IvanInAporia/temp_sensor/design/firmware_design.md

# temp_sensor firmware — design

What the device does, how the code is arranged, and which decisions are load-bearing.

| | |
|---|---|
| Target | STM32L010F4P6, **16 KB flash / 2 KB RAM**, Cortex-M0+ |
| Board | temp_sensor v2 (EasyEDA Pro) — see [`../easyeda/review-notes.md`](../easyeda/review-notes.md) |
| Sensor | TI HDC3020 on I2C1, permanently powered |
| Radio | Tuya T3-3S Wi-Fi module on LPUART1, **power-gated** |
| Supply | One NiMH AA cell → TPS61021A boost → 3.3 V |

---

## 1. What it does

Every five minutes: read the cell, read the sensor, decide whether the reading is
worth telling anyone (§4), and if so bring up the Wi-Fi module,
report temperature, humidity and three battery datapoints (percentage, level, and
whether the cell looks damaged), plus one with the lowest the cell was pulled to
in the windows before (§5), and put it away again. Then sleep.

A press of the Wi-Fi button opens the same window for pairing instead, and can
interrupt the sleep to do it. A press made while a report window is open opens one
as soon as that window closes. A device that isn't paired checks back with one short
window every 2 h until the button pairs it (§4).

When something went wrong since the last report got through (a reset, failed
windows or failed sensor reads), or the button opened a pairing window, the next
report also carries a line of diagnostic text, DP 104 (§4). A watchdog resets a board that stops making progress
(§5).

**Reports go out when the temperature moves, and at least every 4 h.** A move of
1.0 °C goes out at once, one of 0.3 °C once 30 min have passed since the last
report, and a room that holds steady still reports every 4 h, so the app can tell
it from a dead device and the battery state gets out (§4). Two other things in the
code follow from reporting on change: the first reading after boot always reports,
and a report is only "spent" once the module confirms the cloud has it.

## 2. Layout

```
libs/src/bsp/bsp.h          the portability boundary — one implementation per board
libs/src/sensor/            HDC3020 driver (trigger-on-demand, CRC-checked)
libs/src/battery/           NiMH cell voltage and sag -> percent, level, damaged
libs/src/report/            the spike filter, the "is this worth the radio" rule,
                              and the diagnostic record (DP 104)
libs/src/tuya_link/         the glue between the cycle and the vendor MCU SDK
temp_sensor_main/           the cycle itself
tuya/                       the vendor Tuya MCU SDK, ported (§7)

temp_sensor_STM32L010F4/    CubeMX project: HAL, startup, and
  Core/Src/bsp_stm32.c        >>> the only file that knows what the hardware is
libs/test/                  host GoogleTest suite (179 tests) over the same C
```

Everything above `bsp.h` compiles for both the target and the host, unchanged and
uncopied: the CubeMX project links `libs/src/*` and `temp_sensor_main/` in as
linked folders, and `libs/CMakeLists.txt` compiles the same files for the tests.
Only the two edges differ — the board (`bsp_stm32.c` vs `test/mocks/bsp_mock.c`)
and the vendor SDK (real vs `test/mocks/tuya_sdk_mock.c`).

**Porting to another board is writing one new file against `bsp.h`.** Nothing
above that header may include `main.h`, a HAL header or a CMSIS header, and no
pin number, peripheral handle or register name belongs on that side of it.

### The LPUART1 interrupt lives in `bsp_stm32.c`, on purpose

The Tuya SDK needs a byte-level receive interrupt armed for the whole time the
module is powered, and the `.ioc` does not enable the LPUART1 global interrupt —
so CubeMX generates neither the vector nor the NVIC call.

The obvious fix is to add it to the `.ioc` and hand-patch `stm32l0xx_it.c` and
`stm32l0xx_hal_msp.c` to match. **That was tried during this work and it silently
destroyed the receive path.** The project was regenerated, everything outside a
USER CODE block went with it, and the build still succeeded afterwards because
nothing references what went missing. The same regeneration also reverted LPUART1
and I2C1 from HSI16 to PCLK1, the I2C timing, the RTC prescaler and PA7's EXTI —
none of which any test or build could see.

So both halves live in [`bsp_stm32.c`](../temp_sensor_STM32L010F4/Core/Src/bsp_stm32.c),
which CubeMX never touches: `LPUART1_IRQHandler` overrides the weak vector in the
startup file, and the NVIC line is enabled once in `BSP_Init()`. If a future
`.ioc` revision ever does enable that interrupt, both definitions will exist and
the link will fail with a duplicate symbol — the loud version of the same problem,
and the right one to have.

The ADC interrupt behind the sag monitor (§5) lives there for the same reason:
`ADC1_IRQHandler` is defined in `bsp_stm32.c`, and its NVIC line is enabled by the
monitor's start and disabled by its halt, never left on.

**Do not "tidy" this into the generated files.**

## 3. The cycle is straight-line code

There is no scheduler, no task, no coroutine and no state machine.
[`temp_sensor_main.c`](../temp_sensor_main/temp_sensor_main.c) is a list of steps
in the order they happen, and a wait is a call that returns when the wait is over:

```c
bool pairing = PairingRequested();

uint16_t battery_mv = BSP_Battery_ReadMv();     /* before any load is switched on */

if (Hdc3020_Read(&reading))
{
    report_due = ReportPolicy_Update(&report_policy, reading.temp_c10, next_cycle_ms, &temp_c10);
    Tuya_SetDps(temp_c10, reading.rh_pct, battery_pct, battery_state);
}

if (report_due || pairing)
{
    RunWifiWindow(report_due, pairing, temp_c10);
}

WaitForNextCycle();
```

This is affordable because **nothing on this device is concurrent.** One job per
wake; the sensor read is a blocking 15 ms; during a Wi-Fi window the module is the
only thing drawing current and there is nothing else that needs the CPU. The only
concurrency is the LPUART receive interrupt, which pushes one byte into the Tuya
SDK's ring buffer and re-arms itself.

What makes the blocking waits cheap is `Tuya_WaitUntil()`: it blocks, but it
services the SDK and idles the core on every pass, so "wait 25 seconds for the
cloud" costs interrupt wakeups rather than a spin.

**The rule that keeps this honest: every wait has a deadline.** Nothing may wait
on the module forever. It is a separate processor on the far end of a UART with no
reset line; if it never answers, the cycle ends and a later one tries again (§4).

**The watchdog is the backstop for that rule** (§5). `Tuya_WaitUntil` feeds it on
every pass, which is only safe because every wait it runs has a deadline. A three-
minute pairing window is far longer than the watchdog's timeout, and that time is
spent in this loop. Anything that waits *without* a deadline (a vendor HAL loop
polling a flag against a stopped tick, the CubeMX `Error_Handler`) stops feeding
it and gets the board reset.

**No state stops the device for good.** On 2026-11-11 the kitchen board went
quiet for about 9 h after a house-wide outage and came back the moment its Reset
button was pressed. The cloud log couldn't say why, but the firmware then had
three ways to end up there: the unpaired latch, a sensor bus left busy, and a hang
with no watchdog. All three are gone. Unpaired is now re-checked every 2 h, a
failed read resets the bus, and the watchdog catches hangs. The report after a
reset now says what came before it (DP 104).

## 4. Why measuring and reporting are priced differently

One HDC3020 conversion is ~110 µA for 13 ms. One report is the T3-3S cold-booting,
associating and reaching the cloud — seconds at tens of milliamps, and on a single
NiMH cell feeding a 3.3 V boost, roughly three times that current *at the cell*.

That ratio is most of the battery life, so the cycle measures often and reports
rarely. The rules, in [`report_policy.h`](../libs/src/report/report_policy.h):

- **A spike must not buy a report.** A median of the last three samples is the
  whole filter — it rejects any single outlier outright, whatever its size. The
  cost is one sample of lag on a genuine step, which at a five-minute cadence
  means a real change is reported up to two periods after it starts.
- **Only temperature triggers.** Humidity is far noisier and would undo the first
  rule; the battery moves so slowly that any useful threshold would take days to
  cross. Both ride along on whatever report the temperature triggers, and the 4 h
  report carries them out of a steady room.
- **`REPORT_TEMP_DELTA_C10` is 0.3 °C**, a little over the sensor's own ±0.2 °C
  typical accuracy, so a report means the temperature moved rather than that the
  sensor wandered.

### How often a report goes out

Three rules, each against the last report that reached the cloud: how far the
filtered temperature has moved from it, and how long ago it was.

| Since the last report | Moved | |
|---|---|---|
| any time | 1.0 °C or more (`REPORT_TEMP_DELTA_FAST_C10`) | report |
| 30 min or more (`REPORT_HOLDOFF_MS`) | 0.3 °C or more | report |
| 4 h or more (`REPORT_MAX_SILENCE_MS`) | anything | report |

- **The hold-off caps small changes at 48 reports a day.** On the 0.3 °C rule
  alone a heating cycle swinging 0.6 °C every 20 min would send 144 a day; with
  it, 48. When the hold-off ends the current reading goes out, so the app is back
  within 0.3 °C. The cost is that a change under 1.0 °C can reach the app up to
  30 min late.
- **The 4 h report tells a steady room from a dead device.** The app shows the
  device offline between windows, so the cloud log is the only sign of life, and
  it shows repeated values. The 4 h report also gets the battery state out of a
  room that never changes. It costs at most 6 reports a day, and only in a room
  that sends almost nothing else.
- **It is an ordinary report.** It commits like any other, and the backoff and
  the unpaired flag apply to it unchanged. It needs a good sensor reading, so a
  dead sensor goes silent instead of repeating its last value: no new log entry
  for more than about 4 h means something is wrong. The code never calls it a
  "heartbeat", which is the Tuya protocol's cmd 0x00.
- **Times are on the schedule** (`next_cycle_ms`), like the backoff and for the
  same reason. The time since the last report stops growing at 4 h, so it can't
  wrap after 49.7 days.
- **What it saves depends on the room.** Replayed on the logs from 2026-10-31 to
  11-07 (`tools/tuya_logs`, with the signal between reports rebuilt by
  interpolation): front board 84 → ≈44 reports a day, kitchen 12 → 10, office
  16 → 15. Indoor rooms barely change. The front board's temperature moves all
  day, and the hold-off halves its reports.

### Deciding and committing are two calls

`ReportPolicy_Update()` decides; `ReportPolicy_ReportSent()` commits. A window that
did not deliver simply never commits, so the next cycle still finds the change
outstanding. Otherwise a dropped report would wait for the next 4 h report, far
too late for a change worth sending.

Any window that delivers commits this cycle's reading, pairing windows included:
it pushed that reading, so the 0.3 °C and the 4 h count from it. A cycle whose
sensor read failed commits nothing, because what went out was an older reading.

### Delivered means the module said so

Reaching the cloud is not the same as delivering. The kitchen board's window at
08:34 on 11-10 came online in the Tuya event log, but its DPs never showed up, and
the firmware committed them anyway. About 1 in 20–28 windows looked like that on
the kitchen and office boards.

So the push after the cloud is up (`Tuya_ReportCachedDpsWithAck`) sends DPs 101,
103 and 104, then humidity and the battery DPs as plain reports, and the
**temperature last, as a synchronous report** (cmd 0x22). The module answers it
(0x23) once the cloud has it, or refuses after 5 s if it can't deliver. The
plain reports go ahead of it on the same connection, so that one answer covers
the whole push. It is only one because the SDK allows no second synchronous
report before the first is answered (`tuya/protocol.h`, item 14). The answers to
the module's own status queries (`all_data_update`) stay plain.

| The module | The report | The window |
|---|---|---|
| answers yes | delivered, committed | powers off at once: no 2 s drain |
| refuses | not delivered: retried like a failed window | powers off at once |
| does not answer within 6 s, and has answered before in this run | not delivered | powers off |
| does not answer within 6 s, and never has in this run | delivered, by the old rule (reaching the cloud is delivering) | the run stops asking: later windows push plainly and drain 2 s |

- **Whether the module answers at all is unverified** for firmware 3.0.93
  (todo.md, hardware check 5). The last row is the fallback that keeps a module
  without 0x22 working as before, at the cost of one 6 s wait per boot.
- **A pairing window still drains 10 s**, whatever the answer: the app is still
  registering the device.
- **An answer saves power too.** A window powers off as soon as the answer is in,
  rather than holding the module up for the fixed 2 s.

### Backing off after failed windows

A failed window is the most expensive thing the device does: about 29 s with the
module powered (~4 s to alive, then the 25 s cloud timeout). With the router down
every window fails, and retrying the outstanding report on every cycle would keep
the module powered ~10 % of the time — a flat cell in three or four days. So
[`temp_sensor_main.c`](../temp_sensor_main/temp_sensor_main.c) retries twice and
then pauses:

| Failed report windows in a row | Next report window no earlier than |
|---|---|
| 1 or 2 | 5 min after the failed one (`REPORT_RETRY_MS`) |
| 3 | 2 h after it (`REPORT_PAUSE_MS`) |
| any one that found the module unpaired | 2 h after it, with no quick retry spent |

- **Only a window that delivers gives the retries back.** The try at the end of a
  pause gets none of its own, so a long outage costs one window every 2 h, about
  12 a day. The retries after boot follow the same rules.
- **A held-back report is not lost.** Nothing was committed, so it is still
  outstanding when the backoff runs out. The cycle keeps measuring and caching
  throughout.
- **The Wi-Fi button always opens a window, but not a "retry now".** It opens a
  pairing window. One that reaches the cloud clears the backoff; one that doesn't
  changes nothing, because the module spent it waiting for a phone and never tried
  the router.
- **The Reset button is "retry now".** The backoff lives in RAM, so after a reset
  the first cycle reports. Nothing should *need* it any more, though (§3).
- **Times, not cycles**, so a shorter cycle period cannot shorten the retry. They
  are measured on the schedule (`next_cycle_ms`), not off the clock. A cycle
  starts a few ms after its slot, by a different few each time, and a retry timed
  off the clock would miss the next cycle about half the time.

### Checking back while unpaired

A module that was never paired, or was removed in the app, has no network to try,
so a report window would wait out the whole cloud timeout for nothing. Until the
first report after boot lands, the policy asks for one on every cycle.

The module's first state report says whether it is paired. `SMART_CONFIG_STATE`
(0x00), `AP_STATE` (0x01) and `SMART_AND_AP_STATE` (0x06) mean it is waiting to
be paired, and `WIFI_LOW_POWER` (0x05) that it has no network either, having
offered pairing for three minutes with nobody taking it up (`Tuya_IsUnpaired()`).
0x05 went unrecognised until 2026-11-12, when a freshly flashed board reported it
in two report windows (DP 104 `w=2 u=0 m=05`). Each waited out the full cloud
timeout as if a router were down. A router that is down looks different: the
module reports 0x02 and gets the backoff instead. Only the three pairing states
count as "the module entered pairing" for DP 104's `p` field: a module asleep in
low power is offering pairing to nobody.

- **A report window that finds the module unpaired powers off at once**, about
  4 s in rather than 29.
- **The next report window is 2 h off**, the backoff's pause, without spending a
  quick retry. It will not have been paired five minutes later. The cycle keeps
  measuring and caching, so a pairing window has current values to push.
- **But there always is a next one.** Until 2026-11-11 an unpaired answer set a
  flag that stopped all report windows until a pairing window got through or
  somebody pressed Reset. That was one of the ways the kitchen board could have
  gone quiet that day (§3). Checking back costs one ~4 s window every 2 h, about
  0.7 mAh a day, and only while the device really is unpaired.
- **A pairing window is never cut short this way**, since waiting to be paired is
  what it is for. One that gets through clears the backoff. One that nobody
  finishes changes nothing.

### The diagnostic record (DP 104)

When a board goes quiet, the cloud log only shows that it did. The record says
what the device went through since its last report was delivered, and goes out
with the next one that is, as one line of text:

```
r=pin c=17 w=3 u=0 m=02 s=0
```

| Field | Meaning |
|---|---|
| `r` | why this run started, until a report has carried it: `por` power-on or brown-out, `pin` Reset button, `wdg` watchdog, `flt` HardFault or failed HAL call, `sw`, `lp`; `-` once it has gone out |
| `c` | cycles run (5 min each), i.e. how long the device kept going |
| `w` | report windows that did not deliver (pairing windows don't count) |
| `u` | of those, how many found the module unpaired |
| `m` | the module's Wi-Fi state as the last of them closed: `02` no router, `03` router but no cloud, `04` cloud but not confirmed, `00`/`01`/`06` pairing, `05` low power with no network, `ff` never spoke |
| `s` | cycles whose sensor read failed |
| `p` | only after the button opened a pairing window: how many did, how the last one went, and how many reset commands it sent (below) |

The example is the kitchen's 11-11 story replayed in the tests: an outage, three
failed windows that never reached the router, then the Reset button 10 cycles
into the pause. `c=17` says the board kept cycling, so it didn't hang. `m=02`
says the router wasn't there.

`p=2t1` is two pairing windows, the last of which put the module into pairing at
the first reset command and ran out with nobody finishing. The letter says how
far the window got (§7, "Pairing"):

| Letter | The module... |
|---|---|
| `n` | never came alive, so was never asked |
| `x` | never answered the reset command, however many times it went |
| `i` | answered, but never said it was pairing: it went back to its old network |
| `t` | was pairing, and the window ran out first |
| `k` | was pairing, then reached the cloud: paired, or restarted partway and went back to its old network (the sag DPs tell which) |

A pairing window's own push carries the record as it stood before the window
opened, so each attempt is told in the report after it. Three presses that end
`t`, `t`, `k` read `p=2t1` in the window that paired and `p=1k1` in the report
after that. The field goes last, and only while the line has room for it, which
every real line does.

- **Sent only when there is something to say**: after a reset, a pairing window,
  or failed windows or sensor reads. An ordinary report leaves DP 104 out.
- **It survives every reset but a power-on.** It is saved at the end of every
  cycle to four of the RTC's backup registers (`BSP_Retained_*`), with a
  checksum that turns away what a power-on leaves there. The report after the
  Reset button is the one that most needs to say what came before it.
- **The platform needs the DP**: ID 104, identifier `diagnostics`, String,
  report only (`tuya/protocol.h`). `tools/tuya_logs` shows it as the `diag`
  column. At most 40 characters: the SDK builds a string DP in a 48-byte buffer
  with no bounds check, and a static assert in `tuya_link.c` holds that line.

## 5. Power

All datasheet figures; none of this has been measured on the board yet.

| | |
|---|---|
| Stop, core + RTC on LSI | ~1 µA (datasheet) |
| **VREFINT buffer left on in Stop** | **3.0 µA** — the largest single item, so it is switched off before every sleep and brought back (3 ms) by the battery read |
| ADC in Stop | not a listed adder; the ADC's own regulator is left alone |
| IWDG running through Stop | ~0.2 µA: Standby with IWDG + LSI on is 0.8 µA against 0.23 µA off, and LSI (0.4 µA) already runs the RTC |
| Waking every 10 s to feed it | tens of nA on average: a clock restart and a few register writes per wake |
| T3-3S, connected | 48 mA average, 300 mA peak |

Against the ~120 µA measured at the cell in sleep (the boost's own quiescent
current dominates), the watchdog costs under 0.3 %.

Three ordering rules in the code exist for power or for the hardware, not for
style:

1. **The cell is read before the Wi-Fi rail comes up.** A reading taken during a
   report measures the sag, not the charge.
2. **Power before drive, drive before power-off.** PA2 idles high push-pull;
   driving it into an unpowered module back-feeds VBAT through the module's input
   protection, and U5's QOD is unconnected so nothing would discharge that rail.
   `Wifi_RailOn`/`Wifi_RailOff` in `main.c` own this ordering.
3. **Every path out of a Wi-Fi window cuts the supply.** Leaving the module
   powered is the one mistake that empties the cell outright.
4. **The sag monitor never runs into a sleep.** The window stops it once the
   supply is off, and `BSP_McuSleep` halts it first anyway (below).
5. **The watchdog is fed through the sleep, in 10 s chunks.** It runs through Stop
   and the L0 has no option to pause it there, so `BSP_McuSleep` takes the sleep
   as a run of Stops of at most `SLEEP_CHUNK_MAX_MS` with a feed after each.
   Since the RTC and the IWDG both count LSI, the timeout (LSI/256 × 4096) is
   28.4 RTC seconds whatever LSI really runs at, so 10 leaves nearly 3× margin. A
   chunk is fed only if the RTC says time passed: a wakeup that fires at once, or
   a calendar that has stopped, would otherwise spin there with the watchdog
   content. Only a confirmed press ends the sleep early (6, below).
6. **The button is debounced by the BSP, on the 1 ms tick, whatever the MCU is
   doing.** A press is the pin down for 20 ms without a break
   (`button_debounce.h`, table-tested in `button_debounce_test`). SysTick steps
   it whenever the MCU is awake, through the sensor read and every Wi-Fi window.
   In Stop nothing ticks, so the falling edge wakes the MCU and restarts the
   count, and `BSP_McuSleep` stays awake on the tick (`SettleButton`, at most
   100 ms) until the press is decided either way. The last look at the button
   before Stop is made with interrupts masked, so an edge in that gap stays
   pending and ends the WFI at once instead of being handled and forgotten. A
   held or stuck button is one press. The count starts at zero, so **a button
   held through a reset is a press**: hold the Wi-Fi button, press and let go
   of Reset, and the first cycle pairs instead of reporting. That relies on
   main.c's 2 s boot delay to confirm the press before the first cycle asks.
   Without the delay, the press would complete during the first report window
   and pair straight after it. A stuck button does the same once per reset. A
   confirmed press waits
   until the application takes it: one made during a report window keeps the
   next sleep from starting, and opens a pairing window straight after.
   Until 2026-11-12 the application judged the level itself, once on waking and
   once 50 ms into the next cycle. A press made while a window was open was gone
   by then. Re-pairing a freshly flashed board, whose first windows ran ~29 s
   each, three of about four presses opened no window.

### The sag monitor: the cell's minimum under load

The cell pin is the boost's input, after the holder. During a window the module's
transmit bursts pull it down. On the office board's Eneloop the scope shows 1.30 V
dipping to 0.96 V in short peaks. A boost draws roughly constant power, so the
input collapses once the cell and its path can no longer deliver it, no matter how
much charge is left. How deep the dips go is the early warning for that.

The dips are too short for a reading from thread context to catch, so the BSP
samples them from an interrupt
([`BSP_Battery_StartSagMonitor`](../libs/src/bsp/bsp.h)):

- **The ADC runs continuously** over the cell pin and VREFINT, back to back in one
  scan. Its end-of-conversion interrupt keeps two things: the pair with the lowest
  cell/VREFINT ratio, and the lowest point of a running average of the pairs.
  - Each sample carries its own reference because the failing case is exactly when
    the boost stops holding 3.3 V, and a sagging VDDA reads a sagging cell high.
  - The arithmetic is `Battery_SagSamples` in
    [`battery.c`](../libs/src/battery/battery.c), so the host tests cover it. The
    interrupt only feeds it pairs.
- **Why an average.** On the scope on 2026-11-06, a brand-new cell went from
  1.336 V to ~0.8 V on its transmit bursts, which come about every other pair at
  the monitor's rate. Once per window there was also a single narrow spike to
  0.49 V, at the start of the radio's activity. The lowest single reading catches
  the spike, and taken at face value it says a new cell is as weak as the failed
  one. So what matters is how far the cell stays down over a longer time:
  - Each pair counts for 1/128 of the average, about 22 ms at a pair every
    ~171 µs. The weight is `SAG_AVERAGE_SHIFT` in `battery.c`, to be set from the
    DP 103 history.
  - The average starts at the window's first pair, so it doesn't climb from 0.
  - Cell and VREFINT are averaged separately and then taken as a ratio.
  - A lone spike moves the average 1/128 of the way, and a 1 ms dip about 1/20.
    A sag that lasts a tenth of a second shows in full. Bursts on every other
    pair to 0.8 V, between which the cell recovers to 1.25 V, read as their mean,
    about 1.02 V.
- **Why ~22 ms and not ~1.3 ms.** The first build weighted each pair 1/8, on the
  idea that the rail's capacitors carry the module through anything shorter
  than a millisecond. On 2026-11-06 a brand-new Duracell then read 470-750 mV.
  Its one deep dip, 0.40 V for about a millisecond, pulled an average that short
  half way down to it. The module rides that dip out, so it does not show what
  the cell can deliver.
- **Wait mode** holds each conversion until the last result has been read. So a
  late interrupt leaves a gap in the sampling, never a torn pair. That is also why
  its priority is the lowest there is.
- **Rate:** about 86 µs per result (VREFINT's 160.5-cycle sampling, 4×
  oversampling), so a pair every ~171 µs, or ~11,700 interrupts a second, and
  every one ends a `BSP_Idle`. Invisible next to the module's tens of milliamps.
  A dip much shorter than ~100 µs is averaged rather than caught.
- **Coverage:** the window starts the monitor before the supply comes up, so the
  inrush counts, and stops it after the supply is off. `BSP_McuSleep` halts it
  before Stop whatever the caller did. The halt disables the NVIC line first, then
  the ADC interrupt, the conversion, continuous and wait mode, and VREFINT's
  channel, leaving the ADC as `BSP_Battery_ReadMv` expects it.

The result goes out as **DP 101** (`battery_min_voltage`, mV) on the *next*
report. That report carries the lowest value across every window since the last
one that reached the cloud, failed windows included. A window whose sag browned
the module out is the one most worth knowing about, and the one that could not say
so itself. Checked against the scope on 2026-11-03: 945 mV reported against a
961 mV scope minimum, with the cell resting at 1.286 V. A minimum reads slightly low
by nature, since it also picks up the deepest noise spike. A window's own minimum is
not reported in that window: the module
queries every DP twice per window, and a value that changed mid-window would
put two different entries into the cloud log. The first window after a reset has
nothing to report and sends no DP 101. Nor does a minimum of 1000 mV or above:
the boost still has plenty of margin there, and the DP would only be noise in the
app's history (the threshold is in
[`tuya_link.c`](../libs/src/tuya_link/tuya_link.c)).

The lowest point of the average goes out the same way, as **DP 103**
(`battery_avg_min_voltage`, mV), and this is what the gauge uses. It is carried
across failed windows and cleared on a battery swap, like DP 101, but it has no
threshold: until the gauge's thresholds are set from its history, every value is
worth having, a healthy cell's most of all.

**Both DPs have to exist on the Tuya platform:** ID 101 and ID 103, Value, report
only, 0..3300, step 1, scale 0, unit mV. See the `PORTED` notes in
[`protocol.h`](../tuya/protocol.h).

### The gauge under load

A cell can have plenty of charge and still be unable to power a report, so the
sag feeds the battery percentage and a damaged flag
([`battery.h`](../libs/src/battery/battery.h)).

**Collapse voltage.** The boost draws roughly constant power, so at the bottom of
a burst `P·R = (Vrest − Vmin)·Vmin`, with no current measurement needed. The path
delivers the most at Vmin = Vrest/2, and the cell stops powering reports at a
resting voltage of `Vc = 2·√(P·R)`. Two cells measured on the office board are the
reference points:

| Cell | Vrest | Vmin | Vc |
|---|---|---|---|
| Healthy Eneloop | 1.286 V | 0.945 V | ~1.135 V |
| Failed Eneloop | 1.29 V | 0.58 V | past the limit: below Vrest/2 |

The failed cell's limit matches the 1.28 V it stopped working at on the front board.

**Vmin is the averaged minimum (DP 103)**, since 2026-11-06. Both reference
points above, and the thresholds below (1210 mV damaged, the 50 mV margin), came
from the lowest single reading, before the average existed. On 2026-11-06 a
brand-new cell's lowest single reading sagged as far as the failed cell's, so these
numbers are provisional. They are to be set again from the DP 103 history (todo.md).

Three details in the code:

- **A sag to half the resting voltage or below reads as collapsing at the resting
  voltage.** P·R turns back down below that point, so at face value a deeper sag
  would read as a healthier cell.
- **No square root.** `Vc ≈ 600 + P·R/600` mV is the tangent at 1.2 V. It only ever
  reads high, by at most 4 mV between 1.10 and 1.30 V and 9 mV at 1.05 and 1.35 V.
- **A resting reading above 2 V gives no sample.** No AA rests that high, so it is a
  bad reference read. Two in a row would otherwise read 0 % and damaged for weeks.

**Trend.** Each window gives one Vc, set against that cycle's resting voltage.
Failed windows count too.

- **Each window is paired with the one before it, and only the lower Vc of the two
  goes in.** A lone deep window never reaches the gauge, but two in a row do. On
  2026-11-05 a healthy cell's first window went to 389 mV from 1.35 V, past half like
  the failed cell, probably while the cell was still being seated. Taken whole, it
  read 0 % and damaged. What tells the failed cell apart is that it does this on
  every window.
- **The first pair on a cell sets the trend outright.** After that, each sample is
  weighed at 1/4, and its pull is capped at ±60 mV first. So no sample moves the
  trend more than 15 mV, and a sustained change gets there in about 8 windows.

Costs of the pairing:
- A cell that is bad from the start reads damaged on its third report instead of
  its second.
- A cell that goes deep only on every other window reads as its better windows.
  Its deep ones still show in DP 101.

The trend lives in RAM and is cleared on reset. A swap the MCU rides through on the
3.3 V rail's ~100 µF is caught by the resting voltage rising 50 mV or more since the
last cycle, which a cell in use never does. That also clears DP 101's carried
minimum.

**Percentage.** The 0 % point moves up from 1.10 V to Vc + 50 mV, and the curve above
it is stretched back over 0–100. So a full cell still reads 100, and 0 % arrives
while reports still get out. Today's healthy office cell reads 63 % rather than the
plain curve's 67 %. The failed cell reads 0 %, Low.

**DP 102 `battery_damaged`** is true from a trend of 1210 mV up, midway between the
two cells. Vc never exceeds the resting voltage, so only a cell still resting at
1.21 V or more can trip it: an ordinary cell running flat reads empty, not damaged.
It is sent false as well, so a good cell clears it in the app. Recharging doesn't
hide a bad cell. If the failed cell kept its resistance at 1.39 V, it would sag to
only ~0.97 V, about what the healthy cell does today, yet still collapse at ~1.28 V.
The minimum alone can't tell the two apart.

**The DP has to exist on the Tuya platform:** ID 102, identifier `battery_damaged`,
Bool, report only.

## 6. Flash and RAM

16 KB is the binding constraint and it is not comfortable. The bare CubeMX
skeleton alone was **14.1 KB at `-O0`**, which is why:

- **The Debug configuration is built `-Os -flto`, not `-O0`.** At `-O0` the image
  does not fit, with or without application code. Debugging is against optimised
  code; that is the trade this part forces.
- **`syscalls.c` and `sysmem.c` are excluded from the build.** They are CubeMX's
  newlib stubs, nothing calls them, and their `errno` reference pulled in
  `_impure_data` and newlib's stdio `__sf` — **388 bytes of RAM, 19 % of the
  part**, for functions that are never reached. `--specs=nosys.specs` provides the
  stubs the linker still wants.

Current figures (Debug, `-Os -flto`):

```
   text    data     bss     dec     hex
  16144       8    1720   17872    45d0
```

`bss` includes the linker script's 1024-byte `._user_heap_stack` reservation, so
static RAM is ~704 bytes and the stack has ~1330 available. **Flash holds `text`
plus `data`: 16,152 of 16,384 bytes, leaving ~230. Release (without
`DEBUG`/`NO_SLEEP`) is 36 bytes bigger still: 16,180 + 8, leaving ~196.** (When
`-Os` gave 12.5 KB, the same tree at `-O2` was 13.6 KB, so `-O2` no longer fits.)

On 2026-11-12, from 15,748 + 8: the pairing check (§7, "Pairing") cost 356 bytes:
the answer wait and resend, the `p` field of DP 104 with its fourth retained word,
and the pairing-state watch in the service loop. Most of it is inlined into `main`
by LTO. The button debounce on the tick (§5, item 6) and 0x05 as unpaired cost
another 68, plus 4 of `data` for the count's starting value: the SysTick step and
the settling loop, less the application's own 50 ms check and level reads that
went. Starting the count at zero instead, so a button held through a reset is a
press, then gave back 28.

The 2026-11-11 robustness work cost 1,888 bytes, up from 13,860: the watchdog and
chunked sleep, the I2C bus recovery (~200 B with the HAL de-init it pulls in), the
synchronous report and the string DP (~370 B in `ReportDps`), and the diagnostic
record (~400 B, most of it the hand-rolled formatting, which is still far
cheaper than any printf). The next feature will have to find its own room.
Candidates: `HAL_I2C_DeInit` replaced by register writes, `HAL_GPIO_Init` calls
by direct MODER writes in the recovery.

**If the link starts failing on `region RAM overflowed`, the first place to look
is `WIFI_UART_RECV_BUF_LMT` / `WIFI_DATA_PROCESS_LMT` in
[`../tuya/protocol.h`](../tuya/protocol.h)** — and the answer is not to shrink
them (§7).

## 7. The vendor Tuya SDK

`tuya/` is Tuya's generated MCU SDK for this product: the **standard** Wi-Fi MCU
protocol, v2.6.2. Not the low-power one — the module firmware Tuya's burning tool
flashes for this PID (3.0.93) speaks the standard protocol, and the two share a
frame format but not a command set. A low-power SDK talking to it ignores the
module's opening heartbeat, the module never gets past it, and the window times
out with nothing on the wire but heartbeats. That is how the first bring-up
failed.

Every edit made to the SDK is marked `PORTED:` with the reason. They are:

| File | Change |
|---|---|
| `protocol.c` | `uart_transmit_output` → `BSP_Wifi_TransmitByte`; `all_data_update` → `Tuya_ReportCachedDps` |
| `protocol.h` | receive/process buffers raised from 16/24 to 32/32; `WIFI_TEST_ENABLE` off; notes on `CONFIG_MODE` and the send buffer |
| `mcu_api.c` | four `#error` porting markers removed; `wifi_uart_service`'s fill level hoisted so `wifi_protocol_init` resets it; the oversize-frame branch fixed (it allowed a frame the buffer cannot hold, and left the bad header in place to be found again on every pass — **a wedged parser for the rest of the window**); `mcu_reset_wifi` forgets the cached Wi-Fi state |
| `system.h` | `rx_buf_in` / `rx_buf_out` made `volatile` pointers — they are shared with the receive interrupt, and only the bytes they point at were |

The ring size is load-bearing and **fails silently when too small**.
`uart_receive_input()` drops a byte without a word when the ring is full — no UART
error, nothing any counter can see — so the ring has to cover the longest gap
between `wifi_uart_service()` calls. The longest gap here is `all_data_update()`:
`uart_transmit_output` blocks a byte at a time, so six DP frames (84 bytes) hold
the loop for ~88 ms while the module is free to send a heartbeat or a status
change. Those are 7–8 bytes each; 32 gives a 39-byte ring. The process buffer is
margin rather than a cliff now that an oversize frame is discarded.

**Pairing** is the reset command (`0x04`, `mcu_reset_wifi`), not "reset and select
mode" (`0x05`): the T3-3S pairs over Bluetooth or AP, and `0x04` lets it use both.
The module restarts on it, which is why the SDK has to forget its cached state —
otherwise a module that was online when the button was pressed reads as "paired"
the instant the command goes out. The product runs Tuya's anti-misoperation mode
(`"m":2`): an unpaired reset goes back to the old network after three minutes, the
same three minutes the pairing window waits.

The command is a plain transmit, and **the window makes sure it got there.** The
module answers `0x04` the moment the command arrives (the SDK's `reset_wifi_flag`,
read by `Tuya_PairingAnswered`). With no answer in 2 s the command goes again, up
to three times in all (`AskModuleToPair`). Until 2026-11-12 it went once and
nobody looked. A module that missed it carried on to its old network, and the
window closed as if it had paired, which from outside is a button that did
nothing. Re-pairing took several presses, however long the button was held.
That is what moved suspicion from the button to this command. Whether the
command is really what goes missing is what DP 104's `p` field now records
(§4), together with whether the module ever reported a pairing state
afterwards (`Tuya_PairingEntered`, watched on every service pass because the
state that last shows is the cloud).

The button was looked at first and left alone at that point. PA7 already woke the
MCU on an EXTI edge, and a held press always passed the level checks, so neither
known hole explained a long hold failing. Those holes were a press made while the
MCU was awake in a window, and a bounce edge in the tens of µs before Stop. The
first board flashed with the check then paired after about four presses. Its
DP 104 showed only one had opened a window, and its first two report windows ran
~29 s each because of the unrecognised 0x05 (§4). So both holes were closed the
same day (§5, item 6).

The remaining compiler warnings in `tuya/` (a misleadingly indented
`tuya_strncpy`, an unused local in a `#ifdef`-thinned switch) are untouched vendor
code and are left alone on purpose.

## 8. Tests

`libs/build_and_test.bat` — 179 GoogleTest cases, ~3.5 s, run from **PowerShell or
cmd, not Git Bash** (the preset pins MSYS2 UCRT64 and Git Bash's environment leaks
into it, killing every link step).

Time in the host BSP is explicit, not real: `BSP_GetTimeMs()` only moves when
something that takes time on the device takes time in the mock too. So a test
never waits, and a timeout expires for a reason the test chose.

`temp_sensor_main_test` runs the real cycle against the real sensor driver, gauge,
policy and Tuya glue, with only the board and the vendor SDK faked. What it
asserts is what only exists once the steps are in a line: when the radio comes up,
how long each wait is given, what is measured before the load is switched on, and
that the module is never left powered.

The mock watchdog records the longest stretch of awake time between two feeds,
so "nothing waits unwatched" is a test (`NothingTheCycleDoesAwakeGoesLongUnfed`),
not a promise. The tests added on 2026-11-11 were each checked by breaking the
code they cover (18 deliberate changes, every one caught), and so were the
2026-11-12 pairing tests (18 more) and the button and low-power tests (8 more),
all caught.

The mock module takes a pairing reset one of three ways
(`tuyaSdkMockSetResetAnswer`): it answers and says it is pairing before its
scripted boot goes on (the default), it answers and boots straight back to its
network, or it never gets the command. `tuyaSdkMockLoseResets(n)` loses the
next n on the way.

The mock board deals in presses its debounce has already confirmed: bounce,
glitches and a stuck button are `button_debounce_test`'s, millisecond by
millisecond. What a cycle test scripts is when the press comes: before the cycle
(`bspMockPressButton`), part-way into the next sleep, or while the next window is
open. What can't be tested on the host is the board side of it: the tick, the
edge, the settling and the masked Stop entry in `bsp_stm32.c`. Those are hardware
check 8 in [todo.md](todo.md).

## 9. Things deliberately not done

- **No persistent settings.** All seven DPs are report-only; nothing comes down
  from the cloud, so there is nothing to store. The part's 128 bytes of EEPROM are
  untouched. (The diagnostic record lives in RTC backup registers instead: it
  only has to survive a reset, not a power-off.)
- **No HardFault program counter.** `BSP_FatalReset` marks the reset as a fault
  but doesn't record where. On a Cortex-M0+ the stacked PC needs a naked
  handler, and CubeMX owns `HardFault_Handler`. Add it if `r=flt` ever shows up
  in the log.
- **No battery hysteresis.** The three-level DP is derived statelessly from the
  percentage. Reports are minutes to hours apart, so a level sitting exactly on a
  threshold alternates slowly rather than flapping. Add hysteresis if a bench
  discharge says otherwise.

## 10. The numbers that are still estimates

**The NiMH discharge curve in [`battery.c`](../libs/src/battery/battery.c) is a
datasheet-shaped estimate, not bench data,** except for the full anchor. That one
moved from 1.40 V to 1.32 V on field data: three cells all read 1.32 V on a DMM a
few days off the charger, and at 1.40 V no cell ever read 100 %. The plateau
probably reads low too. The office Eneloop read 71 % at 1.28 V after 24 days, when
the battery budget says it had used only ~8 %. The curve puts things in the right
place and gives the gauge a shape to interpolate along; a discharge run on the
real board should replace it. The table is written as anchors precisely so that is an edit and
not a rewrite, and `battery_test` pins the properties that must hold whatever the
numbers are (monotonic, clamped at both ends, most of the scale on the plateau).

Also not yet measured with this firmware: the T3-3S boot and cloud-connect times
that `WIFI_ALIVE_TIMEOUT_MS` and `WIFI_CLOUD_TIMEOUT_MS` are sized from. The only
data so far is a Tuya MCU-simulator capture of a first pairing: ~3 s from the
module's first heartbeat to its first state report, and ~9 s from "configured" to
"cloud" — which is why the alive timeout is 15 s.

Not yet checked on hardware either: what state the module reports on the boot after
a pairing window nobody finished. Checking back while unpaired (§4) relies on it
less than the old latch did, but it still matters:

- **A module with no network** should come back in a pairing state (0x00, 0x01 or
  0x06), not 0x02. If it reports 0x02, it looks like a down router and gets the
  backoff: about 12 full 29 s windows a day instead of 12 short ones.
- **A module that was paired** should not. The pairing window cuts power at about
  the moment anti-misoperation mode would restore the old network. Tuya documents
  that a power cycle after a reset and before re-pairing also restores it. If this
  module firmware doesn't, a stray press would leave the device unpaired. Before
  2026-11-11 that meant silent until someone paired it again. Now it shows up in
  DP 104 (`u=`, `m=01`) of a pairing that gets through, and the device keeps
  asking every 2 h in the meantime.

Also unverified: **whether module firmware 3.0.93 answers a synchronous report**
(cmd 0x22) at all (§4, "Delivered means the module said so"). If it doesn't,
every run spends one 6 s wait finding out and then reports as before. And
**whether the RTC backup registers ride through the Reset button on this board**:
RM0377 says they do. The first report after a press should read `r=pin` with
`c` above 1 if they do, and `r=pin c=1` after a long run if they don't.
