IvanInAporia/temp_sensor/docs/sensor_component/hdc3020.md

# HDC3020 — Summary for PCB Design and Software

Source: Texas Instruments datasheet **SNAS778D** (June 2021, revised July 2024), file `hdc3020.pdf`.
All figures, diagrams, curves and mechanical drawings are in the PDF; this file is text only.

---

## 1. Device Overview

Integrated capacitive relative humidity (RH) + temperature sensor with I2C interface, ADC, calibration
EEPROM, integrated heater and ALERT output, in a 2.50 mm × 2.50 mm 8-pin WSON package (DEF, 0.8 mm max
height). The sensor cavity is an open cavity with no cover: no PCB wash, and no-clean solder paste is mandatory.

Orderable part number: `HDC3020DEFR` (3000 pcs, large tape & reel, NIPDAU, MSL Level-1-260C-UNLIM,
−40 to 125 °C).

Key typical figures: RH accuracy ±0.5 %RH, temperature accuracy ±0.1 °C, RH long-term drift 0.19 %RH/yr,
temperature long-term drift ±0.03 °C/yr, RH response time 4 s, average current 0.4 µA, supply 1.62 V to 5.50 V,
I2C up to 1 MHz, four selectable I2C addresses.

---

## 2. Pin Configuration and Functions

8-pin WSON plus thermal pad. Transparent top view: pins 1–4 down the left side (SDA, ADDR, ALERT, SCL),
pins 5–8 up the right side (VDD, RESET, ADDR1, GND).

| Pin | Name | Type | Description |
|---|---|---|---|
| 1 | SDA | I/O | Serial data line for I2C, open-drain; requires a pullup resistor |
| 2 | ADDR | I | I2C device address pin. Cannot be left floating |
| 3 | ALERT | O | Interrupt pin, push-pull output. If not used, must be left floating |
| 4 | SCL | I | Serial clock line for I2C |
| 5 | VDD | P | Supply voltage from 1.62 V to 5.50 V |
| 6 | RESET | I | Reset pin, active low, internal pullup resistor to VDD. If not used, tie to VDD |
| 7 | ADDR1 | I | I2C device address pin. Cannot be left floating |
| 8 | GND | G | Ground |
| 9 | Thermal Pad | G | Can be soldered, or left unsoldered. If soldered, attach to a pad connected to GND, or preferably a floating pad. To minimize thermal mass for maximum heater efficiency or to measure ambient temperature, the thermal pad can be left unconnected to the PCB |

Type: I = Input, O = Output, I/O = Input and Output, G = Ground, P = Power.

### 2.1 I2C Address Selection

| ADDR | ADDR1 | 7-bit Address |
|---|---|---|
| GND | GND | 0x44 |
| VDD | GND | 0x45 |
| GND | VDD | 0x46 |
| VDD | VDD | 0x47 |

ADDR and ADDR1 must be connected directly to GND or VDD; they must NOT be left floating.

---

## 3. Absolute Maximum Ratings

Over operating free-air temperature range unless otherwise noted.

| Parameter | Min | Max | Unit |
|---|---|---|---|
| VDD applied voltage | −0.3 | 6.0 | V |
| SCL applied voltage | −0.3 | 6.0 | V |
| SDA applied voltage | −0.3 | 6.0 | V |
| ADDR applied voltage | −0.3 | VDD + 0.3 | V |
| ADDR1 applied voltage | −0.3 | VDD + 0.3 | V |
| ALERT applied voltage | −0.3 | VDD + 0.3 | V |
| RESET applied voltage | −0.3 | VDD + 0.3 | V |
| TJ junction temperature | −55 | 150 | °C |
| Tstg storage temperature | −65 | 150 | °C |

### ESD Ratings

| Model | Value |
|---|---|
| Human body model (HBM), ANSI/ESDA/JEDEC JS-001 | ±2000 V |
| Charged device model (CDM), JEDEC JS-002 | ±750 V |

---

## 4. Recommended Operating Conditions

| Parameter | Min | Max | Unit |
|---|---|---|---|
| VDD supply voltage | 1.62 | 5.5 | V |
| TTEMP — temperature sensor operating free-air temperature | −40 | 125 | °C |
| TRH — RH sensor operating free-air temperature | −20 | 80 | °C |
| THEATER — integrated heater (condensation removal) operating free-air temperature | −40 | 60 | °C |
| RHOR — RH sensor operating range (non-condensing) | 0 | 100 | %RH |

Prolonged operation outside the recommended temperature operating conditions and/or at >80 %RH with
temperature in the higher recommended operating range can result in a shift of sensor reading, with slow
recovery time. Care needs to be taken when measuring RH below 0 °C due to the potential for frost.

### Thermal Information (WSON 8-pin, DEF)

| Metric | Value | Unit |
|---|---|---|
| RθJA junction-to-ambient | 84.9 | °C/W |
| RθJC(top) junction-to-case (top) | N/A | °C/W |
| RθJB junction-to-board | 52.0 | °C/W |
| ψJT junction-to-top characterization parameter | N/A | °C/W |
| ψJB junction-to-board characterization parameter | 51.7 | °C/W |
| RθJC(bot) junction-to-case (bottom) | 30.4 | °C/W |

RθJC(top) and ψJT are not applicable due to the location of the cavity opening at the centre position on the
top surface of the package.

---

## 5. Electrical Characteristics

TA = −40 °C to 125 °C, VDD = 1.62 V to 5.50 V unless otherwise noted.
Typical specifications are at TA = 25 °C, VDD = 1.8 V unless otherwise noted.

### 5.1 Relative Humidity Sensor

| Parameter | Conditions | Min | Typ | Max | Unit |
|---|---|---|---|---|---|
| RHACC accuracy | TA = 25 °C, 10 % to 50 % RH | | ±0.5 | ±2.0 | %RH |
| | TA = 25 °C, 0 % to 70 % RH | | ±1.0 | ±2.0 | %RH |
| | TA = 25 °C, 10 % to 80 % RH | | ±1.0 | ±2.5 | %RH |
| | TA = 25 °C, 10 % to 90 % RH | | ±1.5 | ±3.0 | %RH |
| | TA = 25 °C, 0 % to 100 % RH | | ±1.5 | ±3.5 | %RH |
| RHREP repeatability | Low Power Mode 0 (lowest noise) | | ±0.02 | | %RH |
| | Low Power Mode 1 | | ±0.02 | | %RH |
| | Low Power Mode 2 | | ±0.03 | | %RH |
| | Low Power Mode 3 (lowest power) | | ±0.04 | | %RH |
| RHHYS hysteresis | 10 % to 90 % RH | | ±0.8 | | %RH |
| RHRT response time | 10 % to 90 % RH, t63 % step | | 4 | | s |
| RHLTD long-term drift | | | 0.19 | | %RH/yr |
| RHPSRR supply sensitivity, RH accuracy | VDD = 1.8 V to 5.5 V | −10 | 1.8 | 10 | m%RH/V |

Accuracy excludes hysteresis and long-term drift. Long-term drift is based on THB (temperature humidity bias)
testing using an Arrhenius-Peck acceleration model, and excludes the impact of dust, gas-phase solvents and
other contaminants such as vapors from packaging materials, adhesives or tapes. Repeatability typical values
are a 3-sigma measurement over both temperature and supply voltage. The hysteresis value is the difference
between the RH measurement in a rising and falling RH environment, at a specific RH point. Actual response
times vary depending on system thermal mass and airflow.

### 5.2 Temperature Sensor

| Parameter | Conditions | Min | Typ | Max | Unit |
|---|---|---|---|---|---|
| TACC accuracy | 0 °C ≤ TA ≤ 50 °C | | ±0.1 | ±0.2 | °C |
| | −40 °C ≤ TA ≤ 100 °C | | ±0.1 | ±0.3 | °C |
| | −40 °C ≤ TA < 125 °C | | ±0.1 | ±0.4 | °C |
| TREP repeatability | Low Power Mode 0 (lowest noise) | | ±0.04 | | °C |
| | Low Power Mode 1 | | ±0.05 | | °C |
| | Low Power Mode 2 | | ±0.06 | | °C |
| | Low Power Mode 3 (lowest power) | | ±0.08 | | °C |
| TRT response time (stirred liquid) | 25 °C < TA < 75 °C, t63 % step, Rogers 4350B PCB 1.575 mm thickness | | 2 | | s |
| TLTD long-term drift | | | ±0.03 | | °C/yr |
| TPSRR supply sensitivity, temperature accuracy | | −25 | −5.7 | 25 | m°C/V |

### 5.3 Sensor Timing

| Parameter | Conditions | Typ | Max | Unit |
|---|---|---|---|---|
| tmeas measurement duration (RH plus T) | Low Power Mode 0 (lowest noise) | 12.5 | 14.1 | ms |
| | Low Power Mode 1 | 7.5 | 8.4 | ms |
| | Low Power Mode 2 | 5.0 | 5.7 | ms |
| | Low Power Mode 3 (lowest power) | 3.7 | 4.2 | ms |

### 5.4 SCL, SDA Pins

| Parameter | Conditions | Min | Max | Unit |
|---|---|---|---|---|
| VIL low-level input voltage | | | 0.3 × VDD | V |
| VIH high-level input voltage | | 0.7 × VDD | | V |
| VOL low-level output voltage | IOL = 3 mA | | 0.4 | V |
| IIN input leakage current | SDA and SCL pins | −0.5 | 0.5 | µA |
| CIN input capacitance | | | 4.5 | pF |

### 5.5 Control Pins (ALERT, ADDR, ADDR1, RESET)

| Parameter | Conditions | Min | Max | Unit |
|---|---|---|---|---|
| VOH high-level output voltage — ALERT | IOH = −100 µA | VDD − 0.2 | | V |
| VOH high-level output voltage — ALERT | IOH = −3 mA | VDD − 0.4 | | V |
| VOL low-level output voltage — ALERT | IOL = 100 µA | | 0.2 | V |
| VOL low-level output voltage — ALERT | IOL = 3 mA | | 0.4 | V |
| VIH high-level input voltage — ADDR, ADDR1, RESET | | 0.7 × VDD | | V |
| VIL low-level input voltage — ADDR, ADDR1, RESET | | | 0.3 × VDD | V |
| II input leakage current — ADDR and ADDR1 | VI = VDD or GND | −0.5 | 0.5 | µA |

### 5.6 Power Supply

| Parameter | Conditions | Typ | Max | Unit |
|---|---|---|---|---|
| IDD_ACTIVE active current | Low Power Mode 0 (lowest noise) | 110 | 170 | µA |
| | Low Power Mode 1 | 108 | 165 | µA |
| | Low Power Mode 2 | 103 | 155 | µA |
| | Low Power Mode 3 (lowest power) | 99 | 153 | µA |
| IDD_SLEEP sleep current | No active measurement, trigger-on-demand mode, TA = 25 °C | 0.36 | 0.75 | µA |
| | No active measurement, trigger-on-demand mode, TA = −40 °C to 125 °C | | 14.5 | µA |
| | No active measurement, auto measurement mode, TA = 25 °C | 0.54 | 1.05 | µA |
| | No active measurement, auto measurement mode, TA = −40 °C to 125 °C | | 15.0 | µA |
| IDD_AVG averaged current | Trigger-on-demand mode, LPM3, triggered at 1 sample per second | 0.7 | | µA |
| | Trigger-on-demand mode, LPM3, triggered at 1 sample per 5 seconds | 0.4 | | µA |
| | Auto measurement mode, LPM0, 1 sample per second | 1.9 | | µA |
| | Auto measurement mode, LPM1, 1 sample per second | 1.3 | | µA |
| | Auto measurement mode, LPM2, 1 sample per second | 1.0 | | µA |
| | Auto measurement mode, LPM3, 1 sample per second | 0.9 | | µA |
| | Auto measurement mode, LPM3, 1 sample every two seconds | 0.7 | | µA |
| PHEATER heater power | Full power 0x3FFF, VDD = 3.3 V | 249 | 368 | mW |
| | Half power 0x03FF, VDD = 3.3 V | 137 | 203 | mW |
| | Quarter power 0x009F, VDD = 3.3 V | 67 | 100 | mW |

Averaged current equation:

```
IDD_AVG_EQN = measurement_freq × IDD_ACTIVE × tmeas + Isleep × (1 − (measurement_freq × tmeas))
```

Verify that units match, for example measurement frequency in Hz, tmeas in seconds, and all currents in the
same unit. Currents do not include I2C read/write communication or pullup resistor current through SCL and SDA.

### 5.7 Reset / Power-Up and EEPROM

| Parameter | Conditions | Min | Typ | Max | Unit |
|---|---|---|---|---|---|
| VPOR power-on reset threshold voltage | Supply rising | | 1.35 | | V |
| VBOR brown-out detect voltage | Supply falling | | 1.19 | | V |
| SensorPUR power-up ready | Sensor ready once VDD ≥ 1.62 V | | 3.5 | 5.0 | ms |
| SensorRR reset ready | Sensor ready after a reset | | 1.3 | 3.0 | ms |
| RRESET RESET pin internal pullup resistance | | | 49 | | kΩ |
| tRESET_NPW negative pulse width to trigger hard reset | | 1 | | | µs |
| OSEND EEPROM program endurance | | 1000 | | 50000 | cycles |
| OSRET EEPROM data retention time | 100 % power-on hours | 10 | | 100 | years |
| tPROG EEPROM programming time | | | 53 | 77 | ms |
| IEEPROM EEPROM write quiescent current | No active measurement; serial bus inactive | | 525 | | µA |

---

## 6. I2C Interface Timing

Minimum and maximum specifications are over −40 °C to 125 °C and VDD = 1.62 V to 5.50 V.
The controller and device have the same VDD value.

| Parameter | Fast Mode Min | Fast Mode Max | Fast Mode Plus Min | Fast Mode Plus Max | Unit |
|---|---|---|---|---|---|
| f(SCL) SCL operating frequency | 1 | 400 | 1 | 1000 | kHz |
| t(BUF) bus-free time between STOP and START | 1.3 | | 0.5 | | µs |
| t(SUSTA) repeated START condition setup time | 0.6 | | 0.26 | | µs |
| t(HDSTA) hold time after repeated START (first clock is generated after this period) | 0.6 | | 0.26 | | µs |
| t(SUSTO) STOP condition setup time | 0.6 | | 0.26 | | µs |
| t(HDDAT) data hold time | 0 | 0.9 | 0 | 0.45 | µs |
| t(SUDAT) data setup time | 100 | | 50 | | ns |
| t(LOW) SCL clock low period | 1.3 | | 0.5 | | µs |
| t(HIGH) SCL clock high period | 0.6 | | 0.26 | | µs |
| t(VDAT) data valid time (data response time) | | 0.9 | | 0.45 | µs |
| tR SDA, SCL rise time | 20 | 300 | 20 × (VDD / 5.5 V) | 120 | ns |
| tF SDA, SCL fall time | 20 | 300 | 20 × (VDD / 5.5 V) | 120 | ns |
| tLPF glitch suppression filter | | 50 | | 50 | ns |

The maximum t(HDDAT) can be 0.9 µs for fast mode, and is less than the maximum t(VDAT) by a transition time.
t(VDAT) = time for data signal from SCL LOW to SDA output (HIGH to LOW, depending on which is worse).

---

## 7. PCB Design Information

### 7.1 External Components and Connections

- SDA requires a pullup resistor. An SCL pullup resistor is required if the system microprocessor SCL pin is
  open-drain. The recommended value for the pullup resistors is generally 5 kΩ; in some applications it can be
  lower or higher. The size is determined by the amount of capacitance on the I2C lines, bus leakage, and the
  communication frequency.
- A 0.1 µF bypass capacitor is recommended between V+ and GND — multilayer ceramic X7R type, with a
  temperature rating that matches the operating range of the application, placed as close as possible to the
  VDD pin.
- ADDR and ADDR1 must be connected directly to GND or VDD for address selection.
- ALERT can be connected to a microcontroller interrupt. Keep ALERT in/out current below 1 mA to prevent the
  device from self-heating. ALERT must be left floating when not in use.
- If not used, connecting the nRESET pin to VDD is best, to avoid glitches on the nRESET pin caused by
  electromagnetic interference.
- The I2C bus voltage can be different than the device VDD. To prevent self-heating in the device, verifying
  that the I2C bus voltage is equal to or greater than VDD is recommended.
- If the heater or the EEPROM programming features are used, the power supply and VDD/GND traces must handle
  up to 100 mA.

### 7.2 Layout Guidelines

1. Isolate all heat sources from the device: position it away from power-intensive board components such as a
   battery, display or microcontroller. Ideally, the only onboard component close to the device is the supply
   bypass capacitor.
2. Eliminate copper layers below the device (GND, VDD).
3. Use slots or a cutout around the device to reduce thermal mass and obtain a quicker response time to sudden
   environmental changes. The diameter of the cutout around the part is approximately 6 mm. The important
   details are to implement a separation of thermal planes while allowing for power, ground and data lines,
   and to place the part on the board while still meeting mechanical assembly requirements. (The layout example
   figure notes that for that specific layout the cutout is approximately 30 mils across.)
4. Follow the Example Board Layout and Example Stencil Design in the mechanical section of the PDF. The SCL and
   SDA lines require pullup resistors, and a 0.1 µF X7R capacitor is recommended on the VDD line.
5. Soldering the package thermal pad to a board pad that is left floating is best practice. However, the package
   thermal pad can be left floating to minimize thermal mass for maximum heater efficiency or to measure
   ambient temperature.

Thermal pad trade-off: not soldering the thermal pad helps minimize thermal mass for maximum heater efficiency
or to best measure ambient temperature, and gives the device the best chance to survive a short caused by water
getting under the package due to condensation. Soldering the thermal pad aids the stability of RH measurements,
because temperature measurements are more stable due to the increased thermal mass.

### 7.3 Placement and Environmental Design Notes

- The device measures RH and temperature in the immediate environment, so verifying that local conditions at
  the sensor match the ambient environment is critical.
- Use one or more openings in the physical cover over the device to obtain good airflow even in static conditions.
- Avoid placing the sensor in too strong an airflow (>1 m/s typically); strong airflows can result in large
  temperature and humidity result noise.
- Take care to avoid water condensation. Liquid water condensation on the sensor surface can result in erroneous
  RH readings, and can also get under the package body and create electrical shorts.
- Placing the sensor in a vertical orientation can help condensation droplets roll off the sensor body, and
  prevents dust particles from landing and staying on the sensor.
- Avoid directly exposing the sensor to light. Light can both heat the sensor and accelerate aging, which leads
  to increased RH error over time.
- To avoid self-heating, configure the device to no faster than 1 measurement/second.
- Up to four devices can be monitored on a single I2C bus using the four addresses. Multiple devices with the
  same address on the same I2C bus are not allowed.
- If design space is a constraint, cutouts surrounding the device or the inclusion of small trenches can help
  minimize heat transfer from PCB heat sources to the device.

### 7.4 Package and Land Pattern

Package: WSON, plastic small outline, no lead, 8 pins plus exposed thermal pad (pin 9). All linear dimensions
in millimeters; dimensioning and tolerancing per ASME Y14.5M.

| Dimension | DEF (HDC3020) |
|---|---|
| Body length × width | 2.4 – 2.6 × 2.4 – 2.6 |
| Max height | 0.8 (body 0.7 – 0.8) |
| Standoff | 0.00 – 0.05 |
| Exposed thermal pad | 1.2 ± 0.1 × 1.9 ± 0.1 |
| Lead pitch | 6 × 0.5 |
| Lead width | 8 × 0.2 – 0.3 |
| Lead length | 8 × 0.35 – 0.45 |
| Sensing area | Ø 0.612 – 0.912 cavity exposing sensor surface |
| Seating plane flatness | 0.08 |
| Package drawing | DEF0008A-C01 (4228892/B) |

Land pattern example:

- 8 × pad 0.6 mm × 0.25 mm
- 6 × 0.5 mm pitch
- Thermal pad 1.2 mm × 1.9 mm
- Overall pattern span 2.3 mm
- Corner radius R0.05 typ
- Solder mask: non-solder-mask-defined preferred, 0.07 mm max all around; solder-mask-defined 0.07 mm min all around

Stencil design example (based on 0.125 mm thick stencil):

- 8 × aperture 0.6 mm × 0.25 mm, 6 × 0.5 mm pitch
- Exposed pad aperture 1.13 mm × 1.71 mm — 85 % printed solder coverage by area under package
- Laser cutting apertures with trapezoidal walls and rounded corners may offer better paste release;
  IPC-7525 may have alternate design recommendations

Other package notes:

- Customers must maintain adequate clearance from the sensing region to allow for proper functioning of the
  humidity sensor (0.1 mm minimum, plus a 0.75 mm reference zone shown on the drawing).
- The pick-and-place nozzle internal diameter has to be between 0.915 and 1.875 mm.
- The package is designed to be soldered to a thermal pad on the board (see TI literature SLUA271).
- Vias are optional depending on application. If vias are implemented, refer to their locations shown on the
  board layout view. Vias under paste should be filled, plugged or tented.
- Tape and reel: 330.0 mm reel diameter, 12.4 mm reel width W1, A0 = B0 = 2.75 mm, K0 = 1.3 mm,
  P1 = 8.0 mm, W = 12.0 mm, pin 1 quadrant Q1, 3000 pcs per reel.

### 7.5 Storage, Assembly and Rework

- Follow correct storage and handling procedures during board assembly. Avoid long exposure to UV and visible
  light, high temperature and high humidity, or exposure to chemical vapors for prolonged periods, as these
  affect RH accuracy. Protect the device from out-gassed solvent vapors produced during manufacturing,
  transport, operation, and from package materials (adhesive tapes, stickers, bubble foils). Avoid exposure to
  outgassing substances such as pink storage foam and chemicals such as acetone and ethylene glycol.
- Reflow: standard reflow soldering ovens can be used, with the standard soldering profile IPC/JEDEC J-STD-020
  and peak temperatures at 260 °C. MSL rating Level-1-260C-UNLIM.
- No-clean solder paste is mandatory, and the paste must not be exposed to water or solvent rinses
  during assembly, because these contaminants can affect sensor accuracy.
- During reflow, the sensor is expected to output a shift in relative humidity. The shift reduces over time as
  the sensor is exposed to typical indoor ambient conditions of 25 °C and 50 %RH for five days (rehydration).
- Rework: TI recommends limiting the device to a single IR reflow with no rework. A second reflow is possible if
  the exposed polymer is kept clean and undamaged, no-clean solder paste is used and the process is not exposed
  to any liquids, and the peak soldering temperature does not exceed 260 °C.
- Bake/rehydration procedure suggested to recover or reduce error from contaminants:
  1. Baking: 100 °C, at less than 5 %RH, for 5 to 10 hours
  2. Rehydration: 25 °C and 50 %RH for 5 days

---

## 8. Software / Firmware Information

### 8.1 Functional Modes

Two modes of operation: **Sleep Mode** and **Measurement Mode**.

- Sleep mode is the manufacturer-set default upon power-up, hard reset through the RESET pin, and soft reset.
  This power-up mode can be reprogrammed (see 8.10).
- A measurement request triggers the device to switch to measurement mode; after completing the conversion the
  device returns to sleep mode.
- The device must be returned to sleep mode to run the heater and to program the EEPROM.
- In measurement mode, temperature and humidity data is only available to be read by the controller once. Any
  following attempts to read temperature and humidity results produce the minimum temperature and humidity values.

Two measurement modes:

- **Trigger-on Demand**: a single measurement of temperature and relative humidity triggered through an I2C
  command on an as-needed basis. After the measurement is converted, the device remains in sleep mode until
  another I2C command is received.
- **Auto Measurement Mode**: recurring measurement of temperature and relative humidity without repeatedly
  initiating a measurement request. The measurement interval can be adjusted from 1 measurement every 2 seconds
  to 10 measurements every second.

After power up, the sensor needs the power-up ready time SensorPUR before it can begin acquisition. All data
bytes are transmitted MSB first. The device operates only as a target device on the I2C bus.

Trigger-on Demand sequence: after the command is issued, the host must provide the sensor enough time to finish
the ordered conversion before starting the subsequent data read.

### 8.2 Low Power Modes

At 25 °C, VDD = 3.3 V:

| LPM | Measurement duration (typ) | Active IQ (typ) | RH measurement noise |
|---|---|---|---|
| LPM0 (lowest noise) | 12.5 ms | 110 µA | ±0.02 %RH |
| LPM1 | 7.5 ms | 108 µA | ±0.02 %RH |
| LPM2 | 5.0 ms | 103 µA | ±0.03 %RH |
| LPM3 (lowest power) | 3.7 ms | 99 µA | ±0.04 %RH |

### 8.3 Conversion Formulas

Each measurement is represented in 16-bit format. Supported RH range 0 % to 100 %, temperature range
−40 °C to 125 °C. The device cannot report values outside the reported range.

```
RH [%]  = 100 * RH_HDC302x / (2^16 - 1)
T  [°C] = -45 + 175 * T_HDC302x / (2^16 - 1)
T  [°F] = -49 + 315 * T_HDC302x / (2^16 - 1)
```

### 8.4 I2C Transaction Formats

- **Write command, no configuration data**:
  `S | I2C address + W | A | Command MSB | A | Command LSB | A | P`
- **Write command with configuration data and CRC**:
  `S | I2C address + W | A | Command MSB | A | Command LSB | A | Data MSB | A | Data LSB | A | CRC | A | P`
- **Read single data result**:
  `S | I2C address + R | A | Data MSB | A | Data LSB | A | CRC | N | P`
- **Read multi data result**:
  `S | I2C address + R | A | Data1 MSB | A | Data1 LSB | A | CRC | A | Data2 MSB | A | Data2 LSB | A | CRC | N | P`
- **Repeated START (send command and retrieve data)**:
  `S | I2C address + W | A | Command MSB | A | Command LSB | A | Sr | I2C address + R | A | Data ... | CRC | N | P`

Measurement readout format: two bytes of temperature, one CRC byte, then two bytes of relative humidity, one
CRC byte.

The I2C read sequence must follow the I2C write sequence used to initiate the read command. A CRC byte always
accompanies data transmitted by the device; the controller must accept it and cannot issue a NACK before the CRC
is received. The device stops transmission of a data byte if the controller fails to ACK after any byte of data.
If the controller attempts to read measurement results prior to completion of a new measurement, the device
responds with a NACK condition.

### 8.5 CRC

| Property | Value |
|---|---|
| Name | CRC-8/NRSC-5 |
| Width | 8 bit |
| Protected Data | Read Data, Write Data, or Both |
| Polynomial | 0x31 (x^8 + x^5 + x^4 + 1) |
| Initialization | 0xFF |
| Reflect Input | False |
| Reflect Output | False |
| Final XOR | 0x00 |
| Example | CRC of 0xABCD = 0x6F |

The CRC covers the contents of the two previously transmitted data bytes; only these two bytes are used to
calculate the checksum.

A CRC byte is sent by the device following: a relative humidity measurement, a temperature measurement, the
status register, and any of the programmed ALERT limit values (High Alert Set, High Alert Clear, Low Alert Set,
Low Alert Clear).

A CRC byte must be sent by the controller following: configuration of any ALERT limit value, configuring the
heater, and writing an offset into the part.

### 8.6 Command Table

| Hex MSB | Hex LSB | Command | Detail |
|---|---|---|---|
| 24 | 00 | Trigger-On Demand Mode — single T and RH measurement | Low Power Mode 0 (lowest noise) |
| 24 | 0B | Trigger-On Demand Mode | Low Power Mode 1 |
| 24 | 16 | Trigger-On Demand Mode | Low Power Mode 2 |
| 24 | FF | Trigger-On Demand Mode | Low Power Mode 3 (lowest power) |
| 20 | 32 | Auto Measurement Mode — 1 measurement per 2 seconds | Low Power Mode 0 (lowest noise) |
| 20 | 24 | Auto Measurement Mode — 1 per 2 s | Low Power Mode 1 |
| 20 | 2F | Auto Measurement Mode — 1 per 2 s | Low Power Mode 2 |
| 20 | FF | Auto Measurement Mode — 1 per 2 s | Low Power Mode 3 (lowest power) |
| 21 | 30 | Auto Measurement Mode — 1 measurement per second | Low Power Mode 0 (lowest noise) |
| 21 | 26 | Auto Measurement Mode — 1 per s | Low Power Mode 1 |
| 21 | 2D | Auto Measurement Mode — 1 per s | Low Power Mode 2 |
| 21 | FF | Auto Measurement Mode — 1 per s | Low Power Mode 3 (lowest power) |
| 22 | 36 | Auto Measurement Mode — 2 measurements per second | Low Power Mode 0 (lowest noise) |
| 22 | 20 | Auto Measurement Mode — 2 per s | Low Power Mode 1 |
| 22 | 2B | Auto Measurement Mode — 2 per s | Low Power Mode 2 |
| 22 | FF | Auto Measurement Mode — 2 per s | Low Power Mode 3 (lowest power) |
| 23 | 34 | Auto Measurement Mode — 4 measurements per second | Low Power Mode 0 (lowest noise) |
| 23 | 22 | Auto Measurement Mode — 4 per s | Low Power Mode 1 |
| 23 | 29 | Auto Measurement Mode — 4 per s | Low Power Mode 2 |
| 23 | FF | Auto Measurement Mode — 4 per s | Low Power Mode 3 (lowest power) |
| 27 | 37 | Auto Measurement Mode — 10 measurements per second | Low Power Mode 0 (lowest noise) |
| 27 | 21 | Auto Measurement Mode — 10 per s | Low Power Mode 1 |
| 27 | 2A | Auto Measurement Mode — 10 per s | Low Power Mode 2 |
| 27 | FF | Auto Measurement Mode — 10 per s | Low Power Mode 3 (lowest power) |
| 2C | 06 | Trigger-On Demand Mode — single T and RH measurement | Low Power Mode 0 (lowest noise) |
| 2C | 0D | Trigger-On Demand Mode | Low Power Mode 1 |
| 2C | 10 | Trigger-On Demand Mode | Low Power Mode 2 |
| 30 | 93 | Auto Measurement Mode | Exit, then return to Trigger-on Demand Mode |
| E0 | 00 | Measurement readout | T and RH (if RH and T are not updated, data reads out all FFs) |
| E0 | 01 | Measurement readout | RH only |
| E0 | 02 | Measurement history readout | Minimum T |
| E0 | 03 | Measurement history readout | Maximum T |
| E0 | 04 | Measurement history readout | Minimum RH |
| E0 | 05 | Measurement history readout | Maximum RH |
| 61 | 00 | Configure ALERT thresholds of T and RH | Set Low Alert |
| 61 | 1D | Configure ALERT thresholds of T and RH | Set High Alert |
| 61 | 0B | Configure ALERT thresholds of T and RH | Clear Low Alert |
| 61 | 16 | Configure ALERT thresholds of T and RH | Clear High Alert |
| E1 | 02 | Read ALERT thresholds of T and RH | Set Low Alert |
| E1 | 1F | Read ALERT thresholds of T and RH | Set High Alert |
| E1 | 09 | Read ALERT thresholds of T and RH | Clear Low Alert |
| E1 | 14 | Read ALERT thresholds of T and RH | Clear High Alert |
| 30 | 6D | Integrated heater | Enable |
| 30 | 66 | Integrated heater | Disable |
| 30 | 6E | Integrated heater | Configure and read back heater settings |
| F3 | 2D | Status register | Read content |
| 30 | 41 | Status register | Clear content |
| 30 | A2 | Soft reset | |
| 36 | 83 | Read NIST ID (serial number) | Bytes 5 and 4 |
| 36 | 84 | Read NIST ID (serial number) | Bytes 3 and 2 |
| 36 | 85 | Read NIST ID (serial number) | Bytes 1 and 0 |
| 37 | 81 | Read Manufacturer ID (Texas Instruments) | 0x3000 |

For Trigger-on Demand Mode there are three pairs of commands where either command in the pair gives the same
results: (a) 0x2400 and 0x2C06, (b) 0x240B and 0x2C0D, (c) 0x2416 and 0x2C10 (the datasheet footnote prints
this last one as "0x2C1"; the command table lists 0x2C10).

The same commands organized by conversion time:

| Conversion rate | 3.7 ms | 5 ms | 7.5 ms | 12.5 ms |
|---|---|---|---|---|
| Trigger on demand | 0x24FF | 0x2416 | 0x240B | 0x2400 |
| 10 measurements per second | 0x27FF | 0x272A | 0x2721 | 0x2737 |
| 4 measurements per second | 0x23FF | 0x2329 | 0x2322 | 0x2334 |
| 2 measurements per second | 0x22FF | 0x222B | 0x2220 | 0x2236 |
| 1 measurement per second | 0x21FF | 0x212D | 0x2126 | 0x2130 |
| 1 measurement per 2 seconds | 0x20FF | 0x202F | 0x2024 | 0x2032 |

Commands other than those documented are undefined and must not be sent to the device.

### 8.7 NVM (EEPROM) Programming Commands

| Hex MSB | Hex LSB | Command | Detail |
|---|---|---|---|
| 61 | 55 | Program ALERT thresholds of T and RH | Transfer ALERT thresholds into non-volatile memory (NVM) |
| A0 | 04 | Program/read offset value of relative humidity and temperature results | |
| 61 | BB | Program/read default device power-on/reset measurement state | Also allows the user to read back the device's default settings to check if EEPROM was programmed successfully |

When performing any NVM programming command, the device must first be placed into sleep mode. After issuing the
command, wait tPROG = 77 ms. No other commands or communications can occur during this 77 ms wait time. Once the
wait is complete, the EEPROM has finished programming and normal operation can resume.

### 8.8 Reset

Four ways to reset: a soft reset command, an I2C general call reset, a power cycle, and applying a zero pulse on
the nRESET pin.

- **Soft reset**: `S | I2C address + W | A | 0x30 | A | 0xA2 | A | P`.
  Resets the status register, reloads the calibration data and programmed humidity/temperature offset error from
  memory, clears previously stored measurement results, and sets interrupt threshold limits back to the default
  conditions.
- **I2C general call reset**: `S | 0x00 | A | 0x06 | A`. Functionally equivalent to the software reset; recognized
  when the sensor is able to process I2C commands.

### 8.9 Auto Measurement Mode Details

- Enable and configure the interval using the commands in 8.6, for example `0x21 0x30` for 1 measurement/second
  at LPM0. TI recommends limiting the sampling interval to no faster than 1 measurement/second to avoid
  self-heating of the temperature sensor. There are 20 possible sampling period and conversion time combinations.
- Readout: for example `0xE0 0x00` followed by repeated START and read of T MSB, T LSB, CRC, RH MSB, RH LSB, CRC.
  Once the readout is complete the device clears the measurement result; if the next read occurs before the
  following conversion, the results read as +130 °C for temperature and +100 %RH for humidity.
- Exit: `0x30 0x93`. The device immediately discontinues any measurement in progress and returns to sleep mode.
- Extreme measurement history: MIN T, MAX T, MIN RH and MAX RH are updated only in auto measurement mode. They
  can be read out in auto measurement mode and during sleep mode, and can be reset to the starting value only
  with a reset event.

| Configuration | MIN T | MAX T | MIN RH | MAX RH |
|---|---|---|---|---|
| After reset | 130 °C | −45 °C | 100 % | 0 % |
| Within auto measurement mode | Monitored and latched when appropriate | | | |

Auto Measurement mode reduces system power in two ways: it removes the need to repeatedly initiate a measurement
through an I2C command, eliminating sink current through the SCL and SDA pullup resistors; and it allows a
microcontroller to be programmed into deep sleep, woken only through an interrupt on the ALERT pin.

### 8.10 Override Default Power-On and Device-Reset State

Command sequence:
`S | I2C address + W | A | 0x61 | A | 0xBB | A | CFG MSB | A | CFG LSB | A | CRC | A | P`.

This is an EEPROM programming command: place the device in sleep mode first, and no communications can occur
until the EEPROM programming is complete.

Valid configuration values (CFG MSB is 0x00 for all entries):

| CFG MSB | CFG LSB | CRC | Configuration | Low Power Mode | Measurements per second |
|---|---|---|---|---|---|
| 0x00 | 0x03 | 0xD2 | Automatic Measurement Mode | 0 (lowest noise) | 0.5 |
| 0x00 | 0x05 | 0x74 | Automatic Measurement Mode | 0 | 1 |
| 0x00 | 0x07 | 0x16 | Automatic Measurement Mode | 0 | 2 |
| 0x00 | 0x09 | 0x09 | Automatic Measurement Mode | 0 | 4 |
| 0x00 | 0x0B | 0x6B | Automatic Measurement Mode | 0 | 10 |
| 0x00 | 0x13 | 0x91 | Automatic Measurement Mode | 1 | 0.5 |
| 0x00 | 0x15 | 0x37 | Automatic Measurement Mode | 1 | 1 |
| 0x00 | 0x17 | 0x55 | Automatic Measurement Mode | 1 | 2 |
| 0x00 | 0x19 | 0x4A | Automatic Measurement Mode | 1 | 4 |
| 0x00 | 0x1B | 0x28 | Automatic Measurement Mode | 1 | 10 |
| 0x00 | 0x23 | 0x54 | Automatic Measurement Mode | 2 | 0.5 |
| 0x00 | 0x25 | 0xF2 | Automatic Measurement Mode | 2 | 1 |
| 0x00 | 0x27 | 0x90 | Automatic Measurement Mode | 2 | 2 |
| 0x00 | 0x29 | 0x8F | Automatic Measurement Mode | 2 | 4 |
| 0x00 | 0x2B | 0xED | Automatic Measurement Mode | 2 | 10 |
| 0x00 | 0x33 | 0x17 | Automatic Measurement Mode | 3 (lowest power) | 0.5 |
| 0x00 | 0x35 | 0xB1 | Automatic Measurement Mode | 3 | 1 |
| 0x00 | 0x37 | 0xD3 | Automatic Measurement Mode | 3 | 2 |
| 0x00 | 0x39 | 0xCC | Automatic Measurement Mode | 3 | 4 |
| 0x00 | 0x3B | 0xAE | Automatic Measurement Mode | 3 | 10 |
| 0x00 | 0x00 | 0x81 | Restores Factory Default (Sleep Mode) | No conversions | N/A |

### 8.11 ALERT Output

The ALERT output represents the status of bits 15, 11, 10 and 4 of the status register. It asserts to logic HIGH
upon detection of an event and deasserts to logic LOW when the event has passed or after the status register is
cleared. The ALERT output is activated by default upon power-up and any reset event. The ALERT output goes low
when the device has been disabled using assertion of the RESET pin.

The ALERT pin is a powerful push-pull output; caution must be taken to avoid large currents flowing in and out of
the pin to avoid sensor self-heating. Self-heating increases the temperature of the sensor and causes RH to drop
noticeably.

Four programmable thresholds each for temperature and relative humidity:

1. **Set High Alert**: asserts ALERT when the device measures a temperature or RH level that has risen above this value.
2. **Clear High Alert**: deasserts the ALERT caused by Set High Alert once a measured level has fallen below this value.
3. **Set Low Alert**: asserts ALERT when the device measures a level that has fallen below this value.
4. **Clear Low Alert**: deasserts the ALERT caused by Set Low Alert once a measured level has risen above this value.

Best practice is to program all four thresholds prior to any temperature or RH measurement acquisition.
Programming enough separation between the Set and Clear thresholds is important, because a small distance between
Set and Clear levels can cause the ALERT pin to toggle high and low due to measurement noise.

**Threshold representation**: each threshold is a truncated 16-bit value. The 7 MSBs from a relative humidity
measurement are concatenated with the 9 MSBs from a temperature measurement. The actual measurement results are
always stored as 16-bit values, but when compared against the programmed thresholds the truncated representation
gives a resolution loss of 0.5 °C in temperature and 1 % in relative humidity.

Bit layout of the combined 16-bit threshold (MSB to LSB): RH15..RH9 (7 bits) then T15..T7 (9 bits).

**Default threshold values after a reset event:**

| ALERT Threshold | Default RH threshold | Default T threshold | Hex value | CRC |
|---|---|---|---|---|
| Set High Alert | 80 %RH | 60 °C | 0xCD33 | 0xFD |
| Clear High Alert | 79 %RH | 58 °C | 0xCB2D | 0x22 |
| Set Low Alert | 20 %RH | −10 °C | 0x3266 | 0xAD |
| Clear Low Alert | 22 %RH | −9 °C | 0x3869 | 0x37 |

**Steps to calculate and program a threshold:**

1. Select the desired relative humidity and temperature threshold to program, and the programmed value.
2. Convert the RH and temperature threshold values to their respective 16-bit binary values.
3. Retain the 7 MSBs for relative humidity and the 9 MSBs for temperature.
4. Concatenate the 7 RH MSBs with the 9 T MSBs to complete the 16-bit threshold representation.
5. Calculate the CRC byte from the 16-bit threshold value.

Example: Set High Alert programmed to 90 %RH and 65 °C. 90 %RH converts to 0b1110011001100111 and 65 °C converts
to 0b1010000011101011. The 7 MSBs for RH are 0b1110011 and the 9 MSBs for T are 0b101000001. Concatenated:
0b1110011101000001 = 0xE741, with CRC byte 0x55. Command: `0x61 0x1D 0xE7 0x41 0x55`.
The device responds to reception of an incorrect CRC byte with an I2C NACK.

**Deactivating environmental tracking**: program the Set High Alert thresholds to be lower than the Set Low Alert
thresholds. To disable temperature alert tracking, configure the temperature bits within Set Low Alert to be
larger than the temperature bits within Set High Alert; likewise for the humidity bits to disable humidity alert
tracking. Example sequence: `0x61 0x00 0xFF 0xFF 0xAC` (Set Low Alert 100 %RH, 130 °C) followed by
`0x61 0x1D 0x00 0x00 0x81` (Set High Alert 0 %RH, −45 °C).

**Transfer thresholds into NVM**: `S | I2C address + W | A | 0x61 | A | 0x55 | A | P`. This is an EEPROM
programming command — the device must be in sleep mode, and no communications can occur until programming is
complete. After programming, resetting the device and reading back all ALERT values is recommended to verify
the success of the EEPROM program.

### 8.12 Programmable Measurement Offset

The device can be programmed to return an RH or temperature measurement that accounts for a programmed
non-volatile offset value. A sign bit (bit 15 and bit 7 in the combined RH and temperature offset register)
determines whether to add or subtract the offset from the actual sensor measurement result.

The device must be in sleep mode to change the offset, because results can be unpredictable if the device is in
auto measurement mode. Programming requires an EEPROM write, so I2C communications are not permitted until
offset programming is complete.

The RH measurement uses the measured temperature for correction and does not use the programmed temperature
offset, which allows a temperature offset to be programmed to account for local heating without affecting RH
accuracy.

**Combined 16-bit offset register layout (MSB to LSB):**

| Bit | 15 | 14 | 13 | 12 | 11 | 10 | 9 | 8 | 7 | 6 | 5 | 4 | 3 | 2 | 1 | 0 |
|---|---|---|---|---|---|---|---|---|---|---|---|---|---|---|---|---|
| Field | RH+/− | RH13 | RH12 | RH11 | RH10 | RH9 | RH8 | RH7 | T+/− | T12 | T11 | T10 | T9 | T8 | T7 | T6 |

From the 16-bit representation of relative humidity, bits 13 through 7 are used to represent RHOS. From the
16-bit representation of temperature, bits 12 through 6 are used to represent TOS. The device is factory-shipped
with default values of 0x00 for both RHOS and TOS.

**RH offset bit weights** (minimum programmable offset 0.1953125 %, maximum 24.8046875 %; RH cannot report below
0 %RH even if the offset is negative):

| RH offset bit | Value when programmed to 0 | Value when programmed to 1 |
|---|---|---|
| RH+/− | Subtract | Add |
| RH13 | 0 | 12.5 |
| RH12 | 0 | 6.25 |
| RH11 | 0 | 3.125 |
| RH10 | 0 | 1.5625 |
| RH9 | 0 | 0.78125 |
| RH8 | 0 | 0.390625 |
| RH7 | 0 | 0.1953125 |

**Temperature offset bit weights** (minimum programmable offset 0.1708984375 °C, maximum 21.7041015625 °C;
changing the temperature offset does not affect the RH reading):

| T offset bit | Value when programmed to 0 | Value when programmed to 1 |
|---|---|---|
| T+/− | Subtract | Add |
| T12 | 0 | 10.9375 |
| T11 | 0 | 5.46875 |
| T10 | 0 | 2.734375 |
| T9 | 0 | 1.3671875 |
| T8 | 0 | 0.68359375 |
| T7 | 0 | 0.341796875 |
| T6 | 0 | 0.1708984375 |

**Program an offset**:
`S | I2C address + W | A | 0xA0 | A | 0x04 | A | RH+/-,RHOS | A | T+/-,TOS | A | CRC | A | P`.
Example for +8.20 %RH and −7.17 °C: `0xA0 0x04 0xAA 0x33 0xAC`. There can be a communication pause of at least
50 ms after this command.

**Verify a programmed offset**: `0xA0 0x04` followed by repeated START and read of RH+/-,RHOS then T+/-,TOS then
CRC. The user must wait at least 77 ms after programming an offset before attempting to read back the new value.

### 8.13 Status Register

Read content: `0xF3 0x2D` followed by repeated START and read of status MSB, status LSB, CRC.
Clear content: `0x30 0x41`. The clear command clears only the reset and tracking bits in the status register.

| Bit | Default | Description |
|---|---|---|
| 15 | 1 | Overall Alert Status. 0 = no active alerts; 1 = at least one tracking or reset alert |
| 14 | 0 | Reserved |
| 13 | 0 | Heater Status. 0 = heater disabled; 1 = heater enabled |
| 12 | 0 | Reserved |
| 11 | 0 | RH Tracking Alert, mirrored on the ALERT pin. 0 = no RH alert; 1 = RH alert |
| 10 | 0 | T Tracking Alert, mirrored on the ALERT pin. 0 = no T alert; 1 = T alert |
| 9 | 0 | RH High Tracking Alert. 0 = no RH high alert; 1 = RH high alert |
| 8 | 0 | RH Low Tracking Alert. 0 = no RH low alert; 1 = RH low alert |
| 7 | 0 | T High Tracking Alert. 0 = no T high alert; 1 = T high alert |
| 6 | 0 | T Low Tracking Alert. 0 = no T low alert; 1 = T low alert |
| 5 | 0 | Reserved |
| 4 | 1 | Device Reset Detected Alert, mirrored on the ALERT pin. 0 = no reset detected since last clearing of the status register; 1 = device reset detected (hard reset, soft reset command or supply on) |
| 3 | 0 | Reserved |
| 2 | 0 | Reserved |
| 1 | 0 | Reserved |
| 0 | 0 | Checksum verification of last data write. 0 = pass (correct checksum received); 1 = fail (incorrect checksum received). Can be cleared only by a successful data write or by a reset event |

### 8.14 Heater

Enable: `0x30 0x6D`. Disable: `0x30 0x66`. Configure and read back: `0x30 0x6E`.

The heater architecture is comprised of 14 resistors in parallel, represented by
`HEATER_CONFIG[15:0] = H13 H12 H11 H10 H9 H8 H7 H6 H5 H4 H3 H2 H1 H0`, where each HX bit represents the
configuration of heater #X of 14. The level of heater power also depends on VDD, with higher VDD providing more
heater power and hence more device heating.

| Desired heater configuration | Required HEATER_CONFIG[15:0] (hex) | CRC |
|---|---|---|
| Enable heater full power | 3F FF | 06 |
| Enable heater half power | 03 FF | 00 |
| Enable heater quarter power | 00 9F | 96 |

Example command to configure full power: `0x30 0x6E 0x3F 0xFF 0x06`.

Typical heater resistor values:

| Heater code (hex) | Typical resistor value (Ω) |
|---|---|
| 1 | 1875.7 |
| 2 | 1379.3 |
| 4 | 1361.7 |
| 8 | 674.5 |
| F | 292.4 |
| 10 | 692.0 |
| 20 | 692.0 |
| 40 | 472.8 |
| 80 | 475.3 |
| F0 | 145.2 |
| 100 | 478.0 |
| 200 | 477.6 |
| 400 | 281.6 |
| 800 | 281.6 |
| F00 | 93.2 |
| 1000 | 283.7 |
| 2000 | 284.6 |
| 3FFF | 40.3 |

Heater usage notes:

- Use of the heater increases the die temperature up to 80 °C above ambient temperature (depending on supply
  voltage). Accurate measurement of ambient temperature and relative humidity is not possible while the heater
  is in operation.
- When the heater activates, the operating temperature of the device shall be limited based on the THEATER
  recommended operating conditions.
- The heater evaporates condensate that forms on top of the humidity sensor but does not remove dissolved
  contaminants; contaminant residue can impact the accuracy of the humidity sensor.
- If the sensor cavity is covered by a water droplet and the heater is used to evaporate it, do not exceed
  100 °C and do not raise the temperature too fast. Ramping the temperature too quickly past 100 °C can cause
  the droplet to burst, which can damage the polymer in the sensor cavity. A heater temperature rise to 100 °C
  from ambient must take between 5 and 10 seconds to be safe. Exceeding 100 °C for a short period in a
  non-condensing environment is not a concern.
- Suggested condensation-removal flow: continuously calculate and track the dew point; on detecting a potential
  condensing situation, run a software subroutine that activates the heater; continue measuring and tracking
  %RH; once the %RH reading goes to zero (or near it), turn the heater off to allow cooling. Cooling can take
  several minutes; the temperature measurement continues to verify the device returns to normal operating
  condition before restarting normal service.
- The heater can also be used to verify functionality of the temperature and RH readings, and for RH offset
  error correction.

### 8.15 NIST ID / Serial Number and Manufacturer ID

Each device is configured with an unchangeable unique 48-bit code used to support NIST traceability; the value
can also be used as the unique serial number. Three commands are required to read the full 48-bit value, each
returning two bytes of NIST ID followed by a CRC byte:

| Command | Returns |
|---|---|
| `0x36 0x83` | NIST_ID_5, NIST_ID_4 |
| `0x36 0x84` | NIST_ID_3, NIST_ID_2 |
| `0x36 0x85` | NIST_ID_1, NIST_ID_0 |

From MSB to LSB, the full device NIST ID is read as NIST_ID_5, NIST_ID_4, NIST_ID_3, NIST_ID_2, NIST_ID_1,
NIST_ID_0.

Manufacturer ID: command `0x37 0x81` returns 0x3000 (Texas Instruments).

---

## 9. Related Documentation Referenced by the Datasheet

- Humidity Sensor: Storage and Handling Guidelines (application note)
- Optimizing Placement and Routing for Humidity Sensors (application note)
- HDC3020 EVM User's Guide
- HDC3x Silicon User's Guide
- I2C Pullup Resistor Calculation (application note)
- 85 °C/85 % RH Accelerated Life Test Impact on Humidity Sensors (white paper)
- Leveraging Relative Humidity Sensor Enhanced Features for Ultra-Low-Power System (application note)
- How the HDC3020 Humidity Sensor Family Achieves The Industry's Lowest Drift (application note)
- Why long-term consistent performance matters for relative humidity sensors (technical article)
- Interface to sensors in seconds with ASC Studio (technical article)
- SLUA271 — soldering to a thermal pad on the board

Example code showing how to calculate the CRC along with all other HDC302x communications is available on
ASC Studio.
