IvanInAporia/temp_sensor/(list of files, drawings)

Other design files:
easyeda/P1.schdoc
easyeda/PCB1.pcbdoc
