IvanInAporia/temp_sensor/temp_sensor_main/temp_sensor_main.c

#include "temp_sensor_main.h"

#include "battery.h"
#include "bsp.h"
#include "diag_record.h"
#include "hdc3020.h"
#include "report_policy.h"
#include "tuya_link.h"

_Static_assert(DIAG_WORDS <= BSP_RETAINED_WORDS, "the diagnostic record does not fit the retained words");

// --- Why this file is written as straight-line code ---------------------------
//
// There is exactly one thing to do per wake, and nothing that has to happen
// while it is happening. The sensor read is a blocking 15 ms. The Wi-Fi window
// is minutes at worst and the module is the only thing on the board drawing
// current while it is open. Between windows the MCU is stopped. At no point is
// there a second activity competing for the CPU.
//
// So there is no scheduler, no task, no coroutine and no state machine here:
// the cycle is a list of steps in the order they happen, and a wait is a call
// that returns when the wait is over. The only concurrency on the device is the
// LPUART receive interrupt, which does nothing but push a byte into the Tuya
// SDK's ring buffer and re-arm itself (tuya_link.c).
//
// What makes that affordable is Tuya_WaitUntil(): it blocks, but it services
// the Tuya SDK and idles the core on every pass, so "block for 20 seconds
// waiting for the cloud" costs interrupt wakeups rather than a spin. The one
// rule that keeps this honest is that every wait has a deadline. Nothing here
// may wait on the module forever -- it is a separate processor on the far end
// of a UART with no reset line, and if it never answers, the cycle has to end
// anyway and try again in five minutes.

/* How often the sensor is read. Measuring is cheap enough that this is not
 * really a power decision; it sets how quickly a real temperature change can
 * be noticed, and with the median filter needing one extra sample to confirm a
 * step, how quickly it can be reported (up to two periods). */
#define CYCLE_PERIOD_MS (5u * 60u * 1000u)

/* The module has to boot and finish its start-up handshake before anything may
 * be sent to it (Tuya_IsAlive). On the bench the T3-3S took ~3 s from its
 * first heartbeat to its first state report, plus however long it took to
 * boot to that heartbeat; this is several times that. Exceeding it means the
 * module is not there or not talking our protocol: unpowered, unflashed, the
 * UART miswired, or a module firmware that speaks something else. */
#define WIFI_ALIVE_TIMEOUT_MS (15u * 1000u)

/* Association plus cloud handshake on a healthy network. Past this the window
 * is written off and the report is left uncommitted, so a later cycle retries
 * from scratch -- which is the right shape, because the usual reason for
 * missing this deadline is a router that is down. How much later is
 * REPORT_RETRY_MS. */
#define WIFI_CLOUD_TIMEOUT_MS (25u * 1000u)

/* A pairing window instead: provisioning takes as long as somebody standing at
 * the device takes, which is not 25 seconds. Three minutes is also how long the
 * module itself stays in pairing mode before going back to its old network
 * (CONFIG_MODE in ../tuya/protocol.h), so there is nothing to wait for after.
 *
 * Still under the cycle period, deliberately. Nothing breaks if a window
 * overruns it -- the schedule re-bases rather than firing a burst of catch-up
 * cycles (WaitForNextCycle) -- but a window that outlasted the cadence would
 * mean the device stopped measuring for longer than it sleeps, and three
 * minutes is already far longer than any successful pairing takes. */
#define WIFI_PAIRING_TIMEOUT_MS (3u * 60u * 1000u)

/* How long the module is given to answer the reset command that starts
 * pairing, and how many times the command goes out before the window stops
 * asking. The module answers the moment the command arrives, so silence for
 * this long means it never got there, and sending it again is the only fix.
 *
 * Until 2026-11-12 it went once and nobody looked. A module that missed it
 * just carried on to its old network, and the window closed as if it had
 * paired: from the outside, a button that did nothing. Re-pairing took
 * several presses, however long the button was held, which pointed at this
 * command first. Whether the commands are what goes missing is what the `p`
 * field of DP 104 (diag_record.h) now says. (Presses were being lost too, in
 * windows: see BSP_Wifi_TakeButtonPress in bsp.h.) */
#define WIFI_PAIRING_ANSWER_MS (2u * 1000u)
#define WIFI_PAIRING_SENDS     3u

/* How long the module is given to answer the report's synchronous temperature
 * (Tuya_ReportCachedDpsWithAck). The SDK's notes (protocol.h, item 14) say the
 * module answers with a refusal after 5 s when it cannot deliver, and that
 * the MCU must wait longer than that. A module that has not answered by now
 * is one that does not answer at all. */
#define WIFI_ACK_TIMEOUT_MS (6u * 1000u)

/* Held open after the DPs go out, when the module does not answer for them.
 * mcu_dp_*_update() only queues bytes; the module still has to send them on.
 * Cutting the supply the instant the last byte leaves the shift register
 * throws all of that away. With an answer there is nothing to wait for: it
 * comes back once the cloud has the report. */
#define WIFI_DRAIN_MS (2u * 1000u)

/* A pairing window drains longer: reaching the cloud is where provisioning
 * starts being useful, not where it ends -- the app still has to finish
 * registering the device. */
#define WIFI_PAIRING_DRAIN_MS (10u * 1000u)

/* How long after a report window that never reached the cloud the next one may
 * open.
 *
 * A failed window is the most expensive thing this device does: about 29 s
 * with the module powered (some 4 s to come alive, then the whole cloud
 * timeout). With the router down every window fails, and retried on every
 * cycle that is the module powered ~10 % of the time -- a flat cell in three
 * or four days.
 *
 * So two quick retries, for a router that is rebooting, and then a pause:
 * three failures in a row says it is down and likely to stay down a while.
 * Through a long outage that is one window every two hours, about 12 a day.
 *
 * A module found waiting to be paired goes straight to the pause, with no
 * quick retries: it will not have been paired five minutes later. But it is
 * asked again when the pause runs out, every time, rather than never -- a
 * device that stops trying for good can only be brought back by someone who
 * knows to press Reset. Asking costs one ~4 s window every two hours.
 *
 * Times, not cycles. A shorter CYCLE_PERIOD_MS must not shorten the retry,
 * which is already about as short as a router takes to come back. */
#define REPORT_RETRY_MS (5u * 60u * 1000u)
#define REPORT_PAUSE_MS (2u * 60u * 60u * 1000u)

/* Quick retries before failed report windows start the pause. */
#define REPORT_RETRIES 2u

/* How a window ended. */
typedef enum {
    /* It reached the cloud, and the report with it: confirmed by the module's
     * answer, or -- for a module that never answers -- by reaching the cloud
     * at all. A pairing window that got through ends here too. */
    WINDOW_DELIVERED,

    /* It did not: the module never spoke, never reached the cloud, or the
     * cloud refused or never confirmed the report. */
    WINDOW_FAILED,

    /* The module said it is waiting to be paired, so there was nothing to
     * try. Report windows only: a pairing window waits it out. */
    WINDOW_UNPAIRED,
} WindowResult;

/* What a window leaves for the diagnostic record, besides how it ended. */
typedef struct {
    /* The Wi-Fi state the module last reported. */
    uint8_t module_state;

    /* A pairing window's progress, and the reset commands it sent. */
    DiagPairing pairing;
    uint8_t     pairing_sends;
} WindowNotes;

/* Whether the module answers a synchronous report (Tuya_ReportCachedDpsWithAck)
 * -- not every module firmware does, and 3.0.93 has not been checked. */
typedef enum {
    /* Not asked yet this run. */
    ACK_UNKNOWN,

    /* It has answered. From now on a report it does not answer for has not
     * been delivered. */
    ACK_ANSWERS,

    /* The first report that asked went unanswered. The rest of this run goes
     * back to the old rule -- reaching the cloud is delivering -- and does not
     * spend WIFI_ACK_TIMEOUT_MS on every window finding that out again. */
    ACK_SILENT,
} AckSupport;

static ReportPolicy report_policy;

/* When the next scheduled cycle is due, as a BSP_GetTimeMs() value. Advanced
 * by exactly one period per cycle rather than re-based off the wake time, so a
 * long cycle body does not push the whole series later. */
static uint32_t next_cycle_ms;

/* Quick retries left before the pause. Only a window that gets through refills
 * them, so once a pause runs out the device tries once and, if that fails too,
 * pauses again.
 *
 * Kept in RAM, so the board's Reset button is how to make the device try again
 * right now. The Wi-Fi button is not: it always opens a window, but a pairing
 * one, which takes the module off its network. */
static uint8_t report_retries_left;

/* Report windows are held back until next_cycle_ms reaches this.
 *
 * On the schedule rather than the clock. On the device a cycle starts a few
 * milliseconds after its slot, by a different few each time -- the RTC wakeup
 * and the clock that measures it are both coarse -- so a retry timed off the
 * clock to land five minutes on would miss the cycle five minutes on whenever
 * the failed one had started later than that one, and slip a whole period.
 *
 * A cycle the button brings forward shares the slot before it. Its window is a
 * pairing window, which leaves the hold alone (UpdateBackoff), so that costs
 * nothing. */
static uint32_t report_hold_until_ms;

/* In RAM: a reset asks again. */
static AckSupport ack_support;

/* What the device went through since its last report got through, for DP
 * 104 (diag_record.h). Unlike everything else here it outlives a reset: it is
 * written to the retained words at the end of every cycle, and read back at
 * boot. That is the point of it -- the report after the Reset button is the
 * one that most needs to say what happened before it. */
static DiagRecord diag;

/* The lowest the module's load pulled the cell to, in mV, over the windows
 * since the last one that reached the cloud -- or 0 if none was measured: the
 * lowest single reading (DP 101) and the lowest point of the running average
 * (DP 103). The next window carries them out, so a report says how the windows
 * before it went, failed ones included. A window whose sag browned the module
 * out is the one most worth knowing about, and the one that could not say so
 * itself.
 *
 * In RAM, like the backoff. A battery swap resets them, which is right: they
 * belong to the cell they were measured on. */
static uint16_t battery_min_mv;
static uint16_t battery_average_min_mv;

/* The cell's collapse voltage, estimated over its windows (battery.h). It moves
 * the battery percentage's 0 % point and says whether the cell is damaged.
 *
 * In RAM, so the reset a battery swap normally causes clears it, and so does
 * a swap the MCU rides through: see Battery_IsNewCell. */
static Battery_SagTrend sag_trend;

/* The last resting voltage that could be read, for Battery_IsNewCell. 0 until
 * the first. */
static uint16_t previous_rest_mv;

static uint8_t AskModuleToPair(void);
static uint16_t LowerMv(uint16_t a_mv, uint16_t b_mv);
static DiagPairing PairingOutcome(uint8_t sends, bool reached_cloud);
static bool PushReport(bool have_reading, bool pairing);
static bool ReportBackoffOver(void);
static WindowResult RunWifiWindow(bool have_reading, bool pairing, int16_t temp_c10, uint16_t rest_mv, WindowNotes* notes);
static void SaveDiag(void);
static void UpdateBackoff(WindowResult result, bool pairing);
static void WaitForNextCycle(void);

void TempSensorInit(void)
{
    ReportPolicy_Init(&report_policy);
    Tuya_Init();

    /* The first cycle runs immediately -- the wait is at the end of the body --
     * so the schedule starts one period out. */
    next_cycle_ms = BSP_GetTimeMs() + CYCLE_PERIOD_MS;

    /* No backoff carries over a reset, and no pairing state: the first cycle
     * reports, or finds out the module has nowhere to report to. */
    report_retries_left  = REPORT_RETRIES;
    report_hold_until_ms = next_cycle_ms;
    ack_support          = ACK_UNKNOWN;
    battery_min_mv         = 0u;
    battery_average_min_mv = 0u;
    previous_rest_mv       = 0u;
    Battery_SagTrendReset(&sag_trend);

    /* The record does carry over -- unless this is a power-on, when the
     * retained words hold whatever they came up with, and the checksum turns
     * them away. Either way it now has a reset to report. */
    uint32_t words[DIAG_WORDS];

    for (uint8_t i = 0u; i < DIAG_WORDS; i++)
    {
        words[i] = BSP_Retained_Read(i);
    }

    if (!Diag_Restore(words, &diag))
    {
        Diag_Clear(&diag);
    }

    diag.reset = (uint8_t) BSP_GetResetReason();

    SaveDiag();
}

void TempSensorRun(void)
{
    for (;;)
    {
        TempSensorRunCycle();
    }
}

void TempSensorRunCycle(void)
{
    /* The sleep fed it on the way out; this covers a cycle the button started
     * early, and says plainly that a cycle is progress. */
    BSP_Watchdog_Refresh();

    /* The button first, because a press is usually why this cycle is running at
     * all: it ends the sleep early, or it was made during the last window and
     * kept the sleep from starting. Already debounced by the BSP
     * (BSP_Wifi_TakeButtonPress), so there is nothing to wait for here. */
    bool pairing = BSP_Wifi_TakeButtonPress();

    /* The battery next, while nothing else is powered. One NiMH cell feeding a
     * 3.3 V boost delivers roughly three times the module's current at the
     * cell, so a reading taken with the Wi-Fi rail up measures the sag and not
     * the charge. */
    uint16_t battery_mv = BSP_Battery_ReadMv();

    if (Battery_IsNewCell(previous_rest_mv, battery_mv))
    {
        /* What was measured belongs to the cell that came out. A false alarm
         * costs little: the next two windows measure this cell afresh. */
        Battery_SagTrendReset(&sag_trend);
        battery_min_mv         = 0u;
        battery_average_min_mv = 0u;
    }

    if (battery_mv != 0u)
    {
        previous_rest_mv = battery_mv;
    }

    /* From the windows before this one: this cycle's own is still to come, and
     * the DPs cannot change once the module is up -- it queries them twice
     * per window. One report late, like DP 101. */
    uint16_t      collapse_mv     = Battery_SagTrendMv(&sag_trend);
    uint8_t       battery_pct     = Battery_UsablePercentFromMv(battery_mv, collapse_mv);
    Battery_State battery_state   = Battery_StateFromPercent(battery_pct);
    bool          battery_damaged = Battery_IsDamaged(collapse_mv);

    Hdc3020_Reading reading;
    bool            have_reading = Hdc3020_Read(&reading);
    bool            report_due   = false;
    int16_t         temp_c10     = 0;

    if (!have_reading)
    {
        /* Whatever went wrong on the bus, put it back to idle now, so the next
         * cycle starts clean. A failure that leaves the controller "busy", or
         * the sensor holding SDA, would otherwise fail every read after it --
         * and a device that cannot read reports nothing at all. */
        BSP_Sensor_RecoverBus();
    }

    Diag_CountCycle(&diag, have_reading);

    if (have_reading)
    {
        /* On the schedule rather than the clock, like the backoff and for the
         * same reason (report_hold_until_ms): a hold-off timed off the clock
         * would end a few milliseconds after the cycle 30 minutes on about
         * half the time, and slip a whole period. A cycle the button brings
         * forward counts as the one before it, so after a report it delivers,
         * the hold-off and the 4 h end up to a period early. Harmless. */
        report_due = ReportPolicy_Update(&report_policy, reading.temp_c10, next_cycle_ms, &temp_c10);

        /* Cached whether or not a report is due. The module asks for the
         * current readings itself every time it reconnects, and a pairing
         * window can open with no report pending -- there has to be something
         * to answer with, and it should be this cycle's reading rather than
         * whatever the last report left behind. */
        Tuya_SetDps(temp_c10, reading.rh_pct, battery_pct, battery_state, battery_damaged);
    }

    /* A failed sensor read is not an error to handle, it is a cycle with
     * nothing to say: no report is due, the cached values keep last cycle's
     * reading, and the next cycle tries the sensor again. The only thing that
     * still opens a window is the button.
     *
     * Not even the 4 h report: a sensor that stays dead goes silent rather
     * than repeat its last reading as if it were new, so a cloud log with
     * nothing in it for more than about 4 h says something is wrong. */

    /* Every cycle, report due or not -- ReportBackoffOver says why. */
    bool backoff_over = ReportBackoffOver();

    /* A report held back by the backoff -- after failed windows, or after the
     * module said it was unpaired -- is not lost. Nothing was committed, so
     * the policy still finds it outstanding once the hold ends, and the
     * readings above are cached for a pairing window in the meantime. The
     * button is never held back -- though its window only ends a hold if it
     * gets through. */
    if ((report_due && backoff_over) || pairing)
    {
        /* Cached with the module unpowered, like the readings. Only when there
         * is something to say: an ordinary report leaves DP 104 out. */
        char    diag_text[DIAG_TEXT_MAX];
        uint8_t diag_len = Diag_IsNotable(&diag) ? Diag_Format(&diag, diag_text) : 0u;

        Tuya_SetDiag(diag_text, diag_len);

        WindowNotes  notes;
        WindowResult result = RunWifiWindow(have_reading, pairing, temp_c10, battery_mv, &notes);

        UpdateBackoff(result, pairing);

        if (result == WINDOW_DELIVERED)
        {
            /* It went out with this report, if there was anything in it. */
            Diag_Clear(&diag);
        }
        else if (!pairing)
        {
            /* A pairing window nobody finished is not a failure to report:
             * the module spent it waiting for a phone. */
            Diag_CountFailedWindow(&diag, result == WINDOW_UNPAIRED, notes.module_state);
        }

        if (pairing)
        {
            /* After the clear: the text this window carried was cached before
             * it opened, so how it went is the next report's to say. Every
             * attempt is told that way, including the one that gets through. */
            Diag_CountPairing(&diag, notes.pairing, notes.pairing_sends);

            /* Pressed again while it was open -- most likely because nothing
             * on the board shows that the first press took. This window was
             * that press's answer. Another would put a module that may have
             * just paired back into pairing. A press during a report window,
             * by contrast, is kept, and opens a pairing window when it ends. */
            (void) BSP_Wifi_TakeButtonPress();
        }
    }

    /* Every cycle, so a reset at any point -- the button, the watchdog, a
     * fault -- finds the record at most one cycle old. */
    SaveDiag();

    WaitForNextCycle();
}

static void SaveDiag(void)
{
    uint32_t words[DIAG_WORDS];

    Diag_Store(&diag, words);

    for (uint8_t i = 0u; i < DIAG_WORDS; i++)
    {
        BSP_Retained_Write(i, words[i]);
    }
}

/* Whether a report window may open in this cycle -- which it may, except while
 * a retry wait or the pause after failed windows is still running.
 *
 * Called on every cycle, report due or not, for the sake of what it does on
 * the way out.
 */
static bool ReportBackoffOver(void)
{
    /* Unsigned subtraction, as in WaitForNextCycle: a deadline already behind
     * us wraps to a huge number, so "more left than the longest wait there is"
     * is how a passed deadline shows up. */
    uint32_t remaining_ms = report_hold_until_ms - next_cycle_ms;

    if ((remaining_ms != 0u) && (remaining_ms <= REPORT_PAUSE_MS))
    {
        return false;
    }

    /* Over, so brought up to now. Left where it was, a passed deadline would
     * fall further behind on every quiet cycle, and some 49.7 days on the clock
     * would wrap round to it and read it as a pause just started. */
    report_hold_until_ms = next_cycle_ms;

    return true;
}

/* After a window: one that got through clears the backoff, a report window
 * that did not extends it.
 */
static void UpdateBackoff(WindowResult result, bool pairing)
{
    if (result == WINDOW_DELIVERED)
    {
        /* Whatever kind of window it was: the network works, and anything that
         * was outstanding has just been delivered with it. */
        report_retries_left  = REPORT_RETRIES;
        report_hold_until_ms = next_cycle_ms;

        return;
    }

    if (pairing)
    {
        /* Says nothing about the router -- the module spent the window waiting
         * for a phone, not trying its network -- so it neither counts as a
         * failure nor ends a pause. */
        return;
    }

    uint32_t wait_ms;

    if (result == WINDOW_UNPAIRED)
    {
        /* Straight to the pause, without spending a quick retry: it will still
         * be waiting to be paired five minutes from now. But asked again at
         * the end of it -- see REPORT_PAUSE_MS. */
        wait_ms = REPORT_PAUSE_MS;
    }
    else if (report_retries_left > 0u)
    {
        report_retries_left--;
        wait_ms = REPORT_RETRY_MS;
    }
    else
    {
        wait_ms = REPORT_PAUSE_MS;
    }

    /* From this cycle's slot, not from when the window gave up: timed from
     * ~29 s later, the first retry would miss the next cycle at today's period
     * and wait out one more. */
    report_hold_until_ms = next_cycle_ms + wait_ms;
}

/* Once the cloud is up: push the cached DPs, and say whether the report got
 * there.
 *
 * With a reading to deliver, the push asks the module to answer for it
 * (Tuya_ReportCachedDpsWithAck), and the answer is what decides -- unless the
 * module has never answered one, in which case the old rule stands: reaching
 * the cloud is delivering. Without a reading (a pairing window whose sensor
 * read failed) there is nothing to commit, and nothing to ask about.
 */
static bool PushReport(bool have_reading, bool pairing)
{
    bool     delivered = true;
    uint32_t drain_ms  = 0u;

    if (have_reading && (ack_support != ACK_SILENT))
    {
        Tuya_ReportCachedDpsWithAck();

        if (Tuya_WaitUntil(Tuya_ReportAnswered, WIFI_ACK_TIMEOUT_MS))
        {
            /* The answer comes once the cloud has the report, so there is
             * nothing left in flight to drain. */
            ack_support = ACK_ANSWERS;
            delivered   = Tuya_ReportConfirmed();
        }
        else if (ack_support == ACK_ANSWERS)
        {
            /* It answers, just not this time: past its own 5 s it would have
             * refused, so something else went wrong. Not delivered. */
            delivered = false;
        }
        else
        {
            /* Never answered, not once: this module firmware does not do 0x22.
             * The six seconds just spent servicing it were a longer drain than
             * the old rule's, so its verdict stands, and the rest of the run
             * skips the wait. */
            ack_support = ACK_SILENT;
        }
    }
    else
    {
        Tuya_ReportCachedDps();

        drain_ms = WIFI_DRAIN_MS;
    }

    if (pairing)
    {
        /* Whatever the answer: the app is still registering the device. */
        drain_ms = WIFI_PAIRING_DRAIN_MS;
    }

    if (drain_ms != 0u)
    {
        Tuya_ServiceFor(drain_ms);
    }

    return delivered;
}

/* Ask the module to pair, and make sure it heard: the reset command again
 * whenever WIFI_PAIRING_ANSWER_MS passes with no answer, up to
 * WIFI_PAIRING_SENDS in all. Returns how many went out. Requires
 * Tuya_IsAlive().
 *
 * Asking again cannot cut a pairing short. Each command comes seconds after the
 * one before, while the module is still restarting into pairing, and nobody
 * pairs a module that fast.
 */
static uint8_t AskModuleToPair(void)
{
    uint8_t sends = 0u;

    do
    {
        Tuya_StartPairing();
        sends++;
    } while (!Tuya_WaitUntil(Tuya_PairingAnswered, WIFI_PAIRING_ANSWER_MS) && (sends < WIFI_PAIRING_SENDS));

    return sends;
}

/* How far a pairing window got, for DP 104: whether the module came alive
 * (it was asked only if it did, so `sends` is 0 if not), took the command,
 * said it was pairing, and then reached the cloud.
 *
 * "Reached the cloud" after pairing is usually someone pairing it. It is also
 * what a module looks like if it restarted partway through and, as
 * anti-misoperation mode does after a power cycle, went back to the network it
 * had. The cell's sag in DP 101 and DP 103 is what tells those apart.
 */
static DiagPairing PairingOutcome(uint8_t sends, bool reached_cloud)
{
    if (sends == 0u)
    {
        return DIAG_PAIRING_SILENT;
    }

    if (Tuya_PairingEntered())
    {
        return reached_cloud ? DIAG_PAIRING_REACHED : DIAG_PAIRING_UNFINISHED;
    }

    return Tuya_PairingAnswered() ? DIAG_PAIRING_IGNORED : DIAG_PAIRING_UNANSWERED;
}

/* One report and/or pairing window, start to finish, and how it ended.
 * have_reading says this cycle read the sensor, and temp_c10 is then its
 * filtered temperature. rest_mv is this cycle's resting cell voltage, to set
 * the window's sag against. *notes is filled in for the diagnostic record.
 *
 * Every step has a deadline and every exit path goes through Tuya_PowerOff(),
 * because leaving the module powered is the one mistake that empties the cell
 * outright -- tens of milliamps against a budget built on microamps.
 */
static WindowResult RunWifiWindow(bool have_reading, bool pairing, int16_t temp_c10, uint16_t rest_mv, WindowNotes* notes)
{
    WindowResult result        = WINDOW_FAILED;
    bool         reached_cloud = false;

    notes->pairing_sends = 0u;

    /* The windows before this one: its own minimum is still to be measured.
     * Cached now, with the module still unpowered, like the readings. */
    Tuya_SetBatteryMinMv(battery_min_mv, battery_average_min_mv);

    /* Before the supply, so the module's inrush counts too. */
    BSP_Battery_StartSagMonitor();

    Tuya_PowerOn();

    if (Tuya_WaitUntil(Tuya_IsAlive, WIFI_ALIVE_TIMEOUT_MS))
    {
        if (!pairing && Tuya_IsUnpaired())
        {
            /* No network to try, so the cloud timeout would be waited out for
             * nothing: the window ends here, some 4 s in rather than 29, and
             * the next one is two hours off (UpdateBackoff). */
            result = WINDOW_UNPAIRED;
        }
        else
        {
            if (pairing)
            {
                /* Only now: this is a plain transmit, and one sent into a
                 * module that has not finished booting is simply lost. */
                notes->pairing_sends = AskModuleToPair();
            }

            uint32_t cloud_timeout_ms = pairing ? WIFI_PAIRING_TIMEOUT_MS : WIFI_CLOUD_TIMEOUT_MS;

            reached_cloud = Tuya_WaitUntil(Tuya_IsCloudConnected, cloud_timeout_ms);

            /* The push is unconditional, not gated on a report being due: the
             * cloud is up and the cached readings are this cycle's, so a
             * pairing window pushes the current state too. That is what makes
             * the button confirm to whoever pressed it that the device works. */
            if (reached_cloud && PushReport(have_reading, pairing))
            {
                /* Committed only here, on the one path where the value reached
                 * the cloud. Every other way out of this function leaves the
                 * policy alone, so the next cycle still finds the change
                 * outstanding and tries again -- which matters because
                 * otherwise a dropped change would wait for the 4 h report,
                 * far too late for one worth sending.
                 *
                 * Whatever kind of window it was: a pairing window pushed this
                 * cycle's reading too, so from here on that is what the cloud
                 * shows, and the 0.3 C and the 4 h count from it. Not when the
                 * sensor read failed, though -- what went out then was an
                 * older cycle's reading, and this one has nothing to commit. */
                if (have_reading)
                {
                    ReportPolicy_ReportSent(&report_policy, temp_c10, next_cycle_ms);
                }

                result = WINDOW_DELIVERED;
            }
        }
    }

    /* Before the power goes: Tuya_PowerOn is what forgets it. */
    notes->module_state = Tuya_WifiState();
    notes->pairing      = pairing ? PairingOutcome(notes->pairing_sends, reached_cloud) : DIAG_PAIRING_NONE;

    Tuya_PowerOff();

    /* After the supply, so the monitor covered all of it. Never left running:
     * its interrupt fires every ~170 us. */
    BSP_SagReading sag = BSP_Battery_StopSagMonitor();

    /* Every window counts, failed ones included: a cell whose sag browns the
     * module out does it window after window, and that is the strongest
     * evidence there is. A lone one is screened out by the trend.
     *
     * The averaged minimum, not the single lowest reading: a brand-new cell
     * shows one narrow spike to ~0.5 V at the start of the radio's activity,
     * which the 3.3 V rail's capacitors carry the module through. */
    Battery_SagTrendAdd(&sag_trend, Battery_CollapseMv(rest_mv, sag.average_min_mv));

    if (result == WINDOW_DELIVERED)
    {
        /* What was cached has gone out, so the next report starts from this
         * window alone. */
        battery_min_mv         = sag.min_mv;
        battery_average_min_mv = sag.average_min_mv;
    }
    else
    {
        battery_min_mv         = LowerMv(battery_min_mv, sag.min_mv);
        battery_average_min_mv = LowerMv(battery_average_min_mv, sag.average_min_mv);
    }

    return result;
}

/* The lower of two readings in mV, where 0 is "no reading" rather than 0 V.
 */
static uint16_t LowerMv(uint16_t a_mv, uint16_t b_mv)
{
    if ((a_mv == 0u) || ((b_mv != 0u) && (b_mv < a_mv)))
    {
        return b_mv;
    }

    return a_mv;
}

/* Sleep until the next cycle is due, or until the button says otherwise.
 *
 * A loop, for the schedule: a sleep that runs its length comes back here to
 * advance it. Everything else that can wake the MCU the BSP sleeps through
 * itself.
 */
static void WaitForNextCycle(void)
{
    for (;;)
    {
        uint32_t remaining_ms = next_cycle_ms - BSP_GetTimeMs();

        /* Unsigned subtraction: a deadline already behind us wraps to a huge
         * number, so "more than one period left" is how a missed deadline
         * shows up, not an impossible state. */
        if ((remaining_ms == 0u) || (remaining_ms > CYCLE_PERIOD_MS))
        {
            next_cycle_ms += CYCLE_PERIOD_MS;

            /* Accumulating keeps the series on its original phase, but only
             * while the body is short against the period. A three-minute
             * pairing window is not, and two of them back to back would leave
             * the schedule far enough behind to fire several cycles with no
             * sleep between them. Re-base instead of catching up: the phase is
             * worth nothing here, and a burst of cycles costs sensor reads and
             * possibly reports. */
            uint32_t next_remaining_ms = next_cycle_ms - BSP_GetTimeMs();

            if ((next_remaining_ms == 0u) || (next_remaining_ms > CYCLE_PERIOD_MS))
            {
                next_cycle_ms = BSP_GetTimeMs() + CYCLE_PERIOD_MS;
            }

            return;
        }

        /* Short only for a press the BSP has confirmed, and BSP_Wifi_TakeButtonPress
         * will report: one made during this sleep, or before it, in the window
         * just closed (bsp.h). A glitch on the pin is not one, and a stuck
         * button is one press, not one per period. */
        if (BSP_McuSleep(remaining_ms) < remaining_ms)
        {
            /* The press is why we are awake. Run the cycle now and leave the
             * schedule alone: the next scheduled cycle is still due when it
             * was due, and the press has cost the series nothing. */
            return;
        }
    }
}
