IvanInAporia/temp_sensor/temp_sensor_STM32L010F4/temp_sensor.ioc

Mcu.UserName=STM32L010F4Px
PA10.GPIO_Label=SDA_TEMP_SENS
PA10.Signal=I2C1_SDA
PA13.Signal=SYS_SWDIO
PA14.Signal=SYS_SWCLK
PA2.GPIO_Label=LPUART_WIFI_TX
PA2.Signal=LPUART1_TX
PA3.GPIO_Label=LPUART_WIFI_RX
PA3.Signal=LPUART1_RX
PA4.GPIO_Label=OUT_WIFI_ON
PA4.Signal=GPIO_Output
PA5.GPIO_Label=OUT_SPARE
PA5.Signal=GPIO_Output
PA6.GPIO_Label=ADC_BATT
PA6.Signal=ADC_IN6
PA7.GPIO_Label=IN_WIFI_BUTTON
PA7.Signal=GPXTI7
PA9.GPIO_Label=SCL_TEMP_SENS
PA9.Signal=I2C1_SCL
