IvanInAporia/temp_sensor/temp_sensor_STM32L010F4/Core/Src/main.c

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
/* Includes ------------------------------------------------------------------*/
#include "main.h"

/* USER CODE BEGIN Includes */

/* The board-agnostic half of the firmware.  Everything below these two headers
   lives outside this CubeMX project (../../libs/src, ../../temp_sensor_main)
   and knows nothing about the STM32; the board it runs on is
   Core/Src/bsp_stm32.c and nothing else. */
#include "bsp.h"
#include "temp_sensor_main.h"

/* USER CODE END Includes */

/* USER CODE BEGIN PD */

/* TPS22919 tON is 1750 us typ at VIN 3.6 V, measured into CL = 0.1 uF.  The
   rail here carries 10.1 uF (C6 + C7), but the switch is slew-rate limited
   (~3 mV/us), so that only asks ~30 mA of its 1.5 A budget and tON holds.
   5 ms leaves margin over tON spread; module boot is handled by the Tuya
   heartbeat handshake, not by this delay. */
#define WIFI_RAIL_TON_MS                5U

/* USER CODE END PD */

ADC_HandleTypeDef hadc;

I2C_HandleTypeDef hi2c1;

UART_HandleTypeDef hlpuart1;

RTC_HandleTypeDef hrtc;

void SystemClock_Config(void);
static void MX_GPIO_Init(void);
static void MX_LPUART1_UART_Init(void);
static void MX_RTC_Init(void);
static void MX_ADC_Init(void);
static void MX_I2C1_Init(void);
/**
  * @brief  The application entry point.
  * @retval int
  */
int main(void)
{

  /* MCU Configuration--------------------------------------------------------*/

  /* Reset of all peripherals, Initializes the Flash interface and the Systick. */
  HAL_Init();

  /* Configure the system clock */
  SystemClock_Config();

  /* Initialize all configured peripherals */
  MX_GPIO_Init();
  MX_LPUART1_UART_Init();
  MX_RTC_Init();
  MX_ADC_Init();
  MX_I2C1_Init();
  /* USER CODE BEGIN 2 */

  // Delay to give the debugger a chance to attach
  HAL_Delay(2000);

  /* MX_LPUART1_UART_Init() above configured PA2/PA3 as AF while PA4 is still
     low, i.e. TX idling high into an unpowered module.  Park them and settle
     into the known-off state; the application calls Wifi_RailOn() when it
     actually wants the module. */
  Wifi_RailOff();

  /* Latches the reset reason, disarms the wakeup timer MX_RTC_Init() left
     running, enables the LPUART1 interrupt, and settles the board into its off
     state.  Must come after every MX_*_Init above, because it uses the handles
     they set up. */
  BSP_Init();

  TempSensorInit();

  /* USER CODE END 2 */

  /* Infinite loop */
  /* USER CODE BEGIN WHILE */
  while (1)
  {
    /* USER CODE END WHILE */

    /* USER CODE BEGIN 3 */

    /* One measurement cycle, then sleep until the next is due.  Everything
       that makes this device what it does is in there; this loop exists only
       because CubeMX owns the shape of main(). */
    TempSensorRunCycle();
  }
  /* USER CODE END 3 */
}

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
/* USER CODE BEGIN 4 */

/**
  * @brief  Bring up the Wi-Fi rail, then hand PA2/PA3 over to LPUART1.
  * @note   Order matters.  PA2 (LPUART1_TX) idles high, push-pull at VDD.
  *         With U5 off, that current leaves through the T3-3S input ESD
  *         diode and part-powers VBAT; U5's QOD pin is unconnected, so
  *         nothing discharges the rail afterwards.  Power first, drive
  *         second.
  */
void Wifi_RailOn(void)
{
  HAL_GPIO_WritePin(OUT_WIFI_ON_GPIO_Port, OUT_WIFI_ON_Pin, GPIO_PIN_SET);
  HAL_Delay(WIFI_RAIL_TON_MS);
  MX_LPUART1_UART_Init();
}

/**
  * @brief  Park PA2/PA3, then cut the Wi-Fi rail.
  * @note   HAL_UART_DeInit() runs HAL_UART_MspDeInit(), which calls
  *         HAL_GPIO_DeInit() on PA2/PA3.  That leaves both pins in analog
  *         mode (MODER = 0b11), so there is no drive, no Schmitt trigger
  *         and no leakage path into the unpowered module.
  */
void Wifi_RailOff(void)
{
  HAL_UART_DeInit(&hlpuart1);
  HAL_GPIO_WritePin(OUT_WIFI_ON_GPIO_Port, OUT_WIFI_ON_Pin, GPIO_PIN_RESET);
}

/* USER CODE END 4 */
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
