IvanInAporia/temp_sensor/temp_sensor_STM32L010F4/Core/Inc/main.h

#define RF_UART hlpuart1
#define LPUART_WIFI_TX_Pin GPIO_PIN_2
#define LPUART_WIFI_TX_GPIO_Port GPIOA
#define LPUART_WIFI_RX_Pin GPIO_PIN_3
#define LPUART_WIFI_RX_GPIO_Port GPIOA
#define OUT_WIFI_ON_Pin GPIO_PIN_4
#define OUT_WIFI_ON_GPIO_Port GPIOA
#define OUT_SPARE_Pin GPIO_PIN_5
#define OUT_SPARE_GPIO_Port GPIOA
#define ADC_BATT_Pin GPIO_PIN_6
#define ADC_BATT_GPIO_Port GPIOA
#define IN_WIFI_BUTTON_Pin GPIO_PIN_7
#define IN_WIFI_BUTTON_GPIO_Port GPIOA
#define SCL_TEMP_SENS_Pin GPIO_PIN_9
#define SCL_TEMP_SENS_GPIO_Port GPIOA
#define SDA_TEMP_SENS_Pin GPIO_PIN_10
#define SDA_TEMP_SENS_GPIO_Port GPIOA
