IvanInAporia/temp_sensor/(commit log)

2025-05-10 Initial schematic and PCB
    [temp_sensor.kicad_pcb, temp_sensor.kicad_sch]
2025-05-11 Added cap at reset and screw hole
    [temp_sensor.kicad_pcb, temp_sensor.kicad_sch]
2025-06-09 Remove a couple of msgs
2025-06-09 Reduce time to read sensor
2026-09-13 First schematic review
    [P1.schdoc, PCB1.pcbdoc]
2026-09-20 hw: Final review
    [P1.schdoc, PCB1.pcbdoc]
2026-09-22 Add STM32 project with HW config only
2026-09-22 Firmware for the v2 board: HDC3020 + Tuya T3-3S on STM32L010F4
    Replaces the retired ESP8266/Arduino sketch. The application is a
    five-minute measure-and-maybe-report cycle written as straight-line
    code: there is one job per wake and nothing concurrent on the board, so
    no scheduler, task, coroutine or state machine is needed. Waits block,
    but Tuya_WaitUntil() services the SDK and idles the core on every pass,
    so a 25 s wait costs interrupt wakeups rather than a spin. Every wait
    has a deadline and every path out of a Wi-Fi window cuts the module's
    supply.
    libs/src/bsp/bsp.h is the portability boundary. Everything above it is
    board-agnostic C compiled unchanged (not copied) for both the target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
    [Datapoint_Temp_Sensor_Custom_202609060650.xls]
2026-09-22 Add old code and sch to then delete
    [temp_sensor.kicad_pcb, temp_sensor.kicad_sch, temp_sensor.step]
2026-10-07 tuya: reset the frame parser's fill level on every window
    wifi_uart_service() kept rx_in as a function-local static, so
    wifi_protocol_init() could not clear it and a partial frame from the
    previous report window sat in front of the first frame of the next one.
    Hoist it to file scope and zero it in wifi_protocol_init().
    [mcu_api.c]
2026-10-07 bsp: no WFI in Debug builds, clear DBGMCU low-power bits in Release
    With the debugger attached, the first interrupt to wake the core from
    BSP_Idle's WFI after the Wi-Fi rail comes up HardFaults: SP drops for
    the exception frames but they never reach SRAM, and the exception
    return pops stale stack. It does not happen without the debugger or
    without the WFI, so it is a debug-in-low-power artefact. NO_SLEEP,
    defined in the Debug configuration, makes BSP_Idle return instead.
    CubeIDE's "Debug in low power modes" sets DBG_SLEEP/STOP/STANDBY, which
    only a power-on reset clears; left set, Stop draws milliamps. Release
    builds now clear them in BSP_Init.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
    [bsp_stm32.c]
2026-10-07 Delay to give the debugger a chance to attach
2026-10-08 tuya: replace the low-power MCU SDK with the standard protocol SDK
    The T3-3S, as flashed by Tuya's burning tool for this PID (firmware
    3.0.93), speaks the standard Wi-Fi MCU protocol. tuya/ held the
    low-power SDK (v1.0.4), which shares the frame format but not the
    command set: it ignored the module's opening heartbeat (0x00), so the
    module never asked for product information or reported its state, and
    every window timed out waiting for Tuya_IsAlive(). Replaced with the
    standard SDK (v2.6.2) generated for the product, and ported:
    - uart_transmit_output -> BSP_Wifi_TransmitByte; all_data_update ->
    Tuya_ReportCachedDps (the module asks with 0x08 on every window).
    - #error porting markers rem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
    [mcu_api.c, protocol.c, protocol.h, system.h, temp_sensor_main.c]
2026-10-10 vscode: track portable settings.json, ignore the rest of .vscode
    Point cmake.sourceDirectory at ${workspaceFolder}/libs instead of an
    absolute path so CMake Tools finds the project on any checkout.
2026-10-10 gitignore: ignore KiCad fp-info-cache
2026-10-10 docs: track a datasheet manifest, browse it with water_tank's app
    The datasheet PDFs stop being tracked and docs/manifest.json becomes the tracked
    stand-in: for each one, where it belongs, which part it is, where to download it
    again, and the SHA-256 of the copy the digests here were written from. 12 MB of
    binary that changes rarely and diffs never leaves the history; the 4 KB record of
    what was read stays in it. The six PDFs moved to
    %LOCALAPPDATA%\temp_sensor\datasheets, which is where the browser reads them.
    No copy of the app comes with it. The Datasheet Browser lives in the water_tank
    checkout and, as of water_tank 717ac91, takes a manifest and derives the rest from
    it -- the tree the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
2026-10-11 Back off after failed report windows (todo 1a)
    A report window that never reaches the cloud leaves the report uncommitted,
    and until now the next cycle simply tried again. With the router down every
    window fails, each one keeps the module powered for ~29 s, and retrying every
    five minutes keeps it powered ~10 % of the time -- a flat cell in three or
    four days.
    Now a failed report window gets two retries 5 min apart, then a 2 h pause; the
    try at the end of a pause gets no retries of its own, so a long outage costs
    about 12 windows a day. Only a window that reaches the cloud resets this,
    pairing windows included. A pairing window that fails changes nothing: the
    module spent it waiting for a p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
2026-10-11 todo: report at least every 4 h, drop item 3
    Fold a quiet-room report into item 2: after 4 h without a committed
    report, report whatever the change, so a steady room still shows signs
    of life in the cloud log. This reverses the "no heartbeat" decision
    and covers item 3's low-battery problem, so item 3 is dropped. Record
    sending only changed DPs as considered and not worth doing.
2026-10-11 Leave an unpaired module unpowered until it is paired (todo 1b)
    A module that was never paired, or was removed in the app, has no network
    to try, yet every report window waited out the full 25 s cloud timeout for
    it. Until the first report after boot lands the policy asks for a window
    on every cycle, so even with the backoff that was about 12 wasted windows
    a day.
    The module's first state report says whether it is paired: 0x00, 0x01 and
    0x06 are the pairing modes (Tuya_IsUnpaired). A report window that comes
    alive in one now powers off at once, about 4 s in instead of 29, and sets
    module_unpaired. While it is set no report window opens, the retries
    after boot included; the cycle keeps measu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
2026-10-11 todo: collect the hardware and manual checks at the end
    Move the checks that need the board, the Tuya app or the MCU simulator
    out of items 1b, 1c, 2 and 5 into one section at the end, to do once the
    code changes are in. Each item keeps a pointer to its check.
    1c's timeouts and item 5's 0x22 check used to come before the code; the
    notes now say what a wrong result means after the fact. Item 2's "before"
    count depends on the app's history reaching back to the old firmware.
    Also fix the --- after 1c, which turned its last paragraph into a heading.
2026-11-04 Report the cell's minimum under load as DP 101
    An interrupt-driven sag monitor samples the cell against VREFINT through
    every Wi-Fi window (ADC continuous + wait mode, halted before any sleep).
    The next report carries the lowest value since the last delivered one,
    failed windows included, and only once it drops below 1000 mV.
    Checked against the scope on 2026-11-03: 945 mV reported against a
    961 mV scope minimum, with the cell resting at 1.286 V.
2026-11-04 Move the battery gauge's 0 % point to the cell's sag; add DP 102
    A cell can have charge left and still be unable to power a report. The
    boost draws constant power, so a cell with high internal resistance
    collapses at a resting voltage where a healthy one still has a good part
    of its charge. The failed office Eneloop sags from 1.29 V to 0.58 V,
    already past half its resting voltage.
    Each Wi-Fi window now gives a collapse voltage: 600 + P.R/600 mV with
    P.R = (rest - min) * min. That is a tangent in place of 2 * sqrt(P.R),
    capped at the resting voltage. Failed windows count too. A trend follows
    it. The first window sets the trend; each later one counts for a quarter
    and moves it at most 15 mV,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
2026-11-05 Count a window's sag only once the next window confirms it
    On 2026-11-05 a charged Eneloop's first window went to 389 mV from
    1.35 V, past half like the failed cell, probably while the cell was
    still being seated. As the cell's first window it was taken whole, and
    the next report read 0 % and damaged.
    A single window can't tell a disturbed window from a bad cell. What
    tells the failed cell apart is that it sags that far on every window. So
    each window's collapse voltage is now paired with the previous window's,
    and only the lower of the two goes into the trend. A lone deep window
    never reaches the gauge, but two in a row do. The first pair on a cell
    sets the trend; after that, nothing chang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
2026-11-07 Drive the gauge from a ~22 ms average of the sag; report it as DP 103
    On 2026-11-06 a brand-new cell sagged as far as the failed Eneloop on the
    office board: its transmit bursts went from 1.336 V to ~0.8 V, with one
    deep dip per window to 0.49 V. Taken at face value, DP 101's lowest
    single reading says any cell on this board is damaged.
    The sag monitor now also keeps the lowest point of a running average of
    its ADC pairs. The arithmetic is Battery_SagSamples in battery.c, so the
    host tests cover it; the ADC interrupt only feeds it pairs. Cell and
    VREFINT are averaged apart and compared as a ratio, so a sagging 3.3 V
    rail can't read the cell high. The average starts at the window's first
    pai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
2026-11-08 Add a script that fetches the sensors' DP reports from the Tuya cloud
    tools/tuya_logs/tuya_logs.py pulls each device's data-point reports
    through Tuya's OpenAPI and keeps them in notes/tuya_logs/: every DP
    value as logged in <name>_raw.csv, and one row per report in
    <name>_reports.csv, with the columns the battery notes use (min, avg,
    %, state, damaged, temperature, humidity). Each run fetches only what
    is newer than the last stored row, prints the new reports, and says how
    long ago each board last reported. The free tier keeps 7 days of logs,
    so it warns when more than that has passed since the last run.
    It uses the standard library only. The cloud project's keys, data center
    and device ID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
2026-11-08 Hold small changes back 30 min and report at least every 4 h (todo 2)
    Reporting on every 0.3 C move had no limit on reports per day: the front
    board's cloud log shows 78-105 a day, about 6 weeks per cell on the battery
    budget. And a room steady to within 0.3 C sent nothing at all, so the app
    could not tell it from a dead device and the battery state never went out.
    Now three rules, each against the last report that reached the cloud:
    - moved 1.0 C or more: report now
    - moved 0.3 C or more: report once 30 min have passed (the hold-off)
    - 4 h have passed: report, whatever the change
    The hold-off caps small-change reports at 48 a day; when it ends the current
    reading goes out, so the app is b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
2026-11-12 Leave no state that only Reset clears; confirm reports; add DP 104 (todo 5, 6)
    On 11-11 the kitchen board stayed silent from the house-wide outage until
    its Reset button was pressed. The cause can't be pinned down from the cloud
    log, but the firmware had three states only a reset clears: a module that
    once said "unpaired" muted the board for good, a stuck I2C bus meant no
    readings and so no reports ever again, and a hang or HardFault spun forever.
    - Unpaired: re-checked every 2 h instead of latched. The check is an
    ordinary window and doesn't spend a backoff retry.
    - Sensor bus: a failed read de-inits I2C, clocks SCL up to 9 times while
    SDA is held low, sends START+STOP and re-inits. Ev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
2026-11-12 Make re-pairing take one press; say how each pairing went (todo 7, 8)
    Re-pairing a board often took several presses of the Wi-Fi button, however
    long it was held. Three causes turned up, one at a time:
    - The pairing reset (0x04) went out once and nobody looked. A module that
    missed it went back to its old network, and the window closed as if it
    had paired. Now the window waits 2 s for the module's answer and sends
    it again, up to three times.
    - 0x05 (WIFI_LOW_POWER) was unknown. A freshly flashed board reported it
    in two report windows (DP 104 "r=pin c=3 w=2 u=0 m=05") and each waited
    out the full cloud timeout as if the router were down. It now counts as
    unpaired: ~4 s, then th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
