IvanInAporia/temp_sensor/(notices)

Notices in the files:
temp_sensor_STM32L010F4/Core/Inc/main.h:
Copyright (c) 2026 STMicroelectronics.
All rights reserved.
This software is licensed under terms that can be found in the LICENSE file
